dettmaru/Release/Hardware/BaseCircuit_V3/Migrate report.txt

Info: Backing up file "/media/daniel/Data/Sciebo/RhizoTech/Hardware/BaseCircuit_V2/sym-lib-table" to file "/media/daniel/Data/Sciebo/RhizoTech/Hardware/BaseCircuit_V2/rescue-backup/sym-lib-table-2018-10-24-13-03-47".
Info: Backing up file "/media/daniel/Data/Sciebo/RhizoTech/Hardware/BaseCircuit_V2/BaseCircuit_V2.sch" to file "/media/daniel/Data/Sciebo/RhizoTech/Hardware/BaseCircuit_V2/rescue-backup/BaseCircuit_V2-2018-10-24-13-03-47.sch".
Info: Backing up file "/media/daniel/Data/Sciebo/RhizoTech/Hardware/BaseCircuit_V2/Powersupply.sch" to file "/media/daniel/Data/Sciebo/RhizoTech/Hardware/BaseCircuit_V2/rescue-backup/Powersupply-2018-10-24-13-03-47.sch".
Info: Backing up file "/media/daniel/Data/Sciebo/RhizoTech/Hardware/BaseCircuit_V2/Interfaces.sch" to file "/media/daniel/Data/Sciebo/RhizoTech/Hardware/BaseCircuit_V2/rescue-backup/Interfaces-2018-10-24-13-03-47.sch".
Info: Backing up file "/media/daniel/Data/Sciebo/RhizoTech/Hardware/BaseCircuit_V2/UserInterface.sch" to file "/media/daniel/Data/Sciebo/RhizoTech/Hardware/BaseCircuit_V2/rescue-backup/UserInterface-2018-10-24-13-03-47.sch".
Info: Backing up file "/media/daniel/Data/Sciebo/RhizoTech/Hardware/BaseCircuit_V2/BaseCircuit_V2.pro" to file "/media/daniel/Data/Sciebo/RhizoTech/Hardware/BaseCircuit_V2/rescue-backup/BaseCircuit_V2-2018-10-24-13-03-47.pro".
Info: Backing up file "/media/daniel/Data/Sciebo/RhizoTech/Hardware/BaseCircuit_V2/BaseCircuit_V2-cache.lib" to file "/media/daniel/Data/Sciebo/RhizoTech/Hardware/BaseCircuit_V2/rescue-backup/BaseCircuit_V2-cache-2018-10-24-13-03-47.lib".
Info: Backing up file "/media/daniel/Data/Sciebo/RhizoTech/Hardware/BaseCircuit_V2/BaseCircuit_V2-rescue.lib" to file "/media/daniel/Data/Sciebo/RhizoTech/Hardware/BaseCircuit_V2/rescue-backup/BaseCircuit_V2-rescue-2018-10-24-13-03-47.lib".
Info: Backing up file "/media/daniel/Data/Sciebo/RhizoTech/Hardware/BaseCircuit_V2/BaseCircuit_V2-rescue.dcm" to file "/media/daniel/Data/Sciebo/RhizoTech/Hardware/BaseCircuit_V2/rescue-backup/BaseCircuit_V2-rescue-2018-10-24-13-03-47.dcm".
Info: Adding library "BaseCircuit_V2-rescue", file "${KIPRJMOD}/BaseCircuit_V2-rescue.lib" to project symbol library table.
Info: Adding library "BaseCircuit_V1-rescue", file "/media/daniel/Data/Sciebo/RhizoTech/Hardware/BaseCircuit_V1/BaseCircuit_V1-rescue.lib" to project symbol library table.
Info: Adding library "ESP32-footprints-Shem-Lib", file "${KIPRJMOD}/ESP32-footprints-Shem-Lib.lib" to project symbol library table.
Info: Adding library "503398-1892", file "${KIPRJMOD}/503398-1892.lib" to project symbol library table.
Info: Adding library "AddedComponents", file "${KIPRJMOD}/AddedComponents.lib" to project symbol library table.
Info: Adding library "LTC3440", file "${KIPRJMOD}/LTC3440.lib" to project symbol library table.
Symbol "ESP32-WROOM" mapped to symbol library "ESP32-footprints-Shem-Lib".
Symbol "GND" mapped to symbol library "power".
Symbol "GND" mapped to symbol library "power".
Symbol "GND" mapped to symbol library "power".
Symbol "STM32L496Zx" mapped to symbol library "AddedComponents".
Symbol "GND" mapped to symbol library "power".
Symbol "GND" mapped to symbol library "power".
Symbol "Crystal" mapped to symbol library "BaseCircuit_V2-rescue".
Symbol "C" mapped to symbol library "BaseCircuit_V2-rescue".
Symbol "C" mapped to symbol library "BaseCircuit_V2-rescue".
Symbol "GND" mapped to symbol library "power".
Symbol "GND" mapped to symbol library "power".
Symbol "CONN_01X08" mapped to symbol library "BaseCircuit_V2-rescue".
Symbol "CONN_01X10" mapped to symbol library "BaseCircuit_V2-rescue".
Symbol "GND" mapped to symbol library "power".
Symbol "CONN_02X40" mapped to symbol library "BaseCircuit_V2-rescue".
Symbol "CONN_02X40" mapped to symbol library "BaseCircuit_V2-rescue".
Symbol "+3.3V" mapped to symbol library "power".
Symbol "GND" mapped to symbol library "power".
Symbol "GND" mapped to symbol library "power".
Symbol "+5VL" mapped to symbol library "power".
Symbol "GND" mapped to symbol library "power".
Symbol "GND" mapped to symbol library "power".
Symbol "GND" mapped to symbol library "power".
Symbol "GND" mapped to symbol library "power".
Symbol "GND" mapped to symbol library "power".
Symbol "GND" mapped to symbol library "power".
Symbol "GND" mapped to symbol library "power".
Symbol "GND" mapped to symbol library "power".
Symbol "GND" mapped to symbol library "power".
Symbol "GND" mapped to symbol library "power".
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
Symbol "LED" mapped to symbol library "BaseCircuit_V2-rescue".
Symbol "R" mapped to symbol library "BaseCircuit_V2-rescue".
Symbol "LED" mapped to symbol library "BaseCircuit_V2-rescue".
Symbol "R" mapped to symbol library "BaseCircuit_V2-rescue".
Info: Symbol library table mapping complete!
