dettmaru/Release/Hardware/Receiver_BLE/Bill of Material/BOM.ods

Reference | Quantity | Value | Footprint | Händler | Ordercode | Kosten pro Stück | Kosten pro Stück netto | Kosten gesamt | Kommentar
C14 C18 | 2 | 100nF | Capacitor_SMD:C_0603_1608Metric_Pad1.08x0.95mm_HandSolder | Farnell | 1759017 | 0,0838 | 0,0838 | 0,1676
C15 C16 | 2 | 4.7µF | Capacitor_SMD:C_0603_1608Metric_Pad1.08x0.95mm_HandSolder | Farnell | 1833803 | 0,354 | 0,354 | 0,708
C2 | 1 | 1.5pF | Capacitor_SMD:C_0603_1608Metric_Pad1.08x0.95mm_HandSolder
D1 | 1 | LED | LED_SMD:LED_0603_1608Metric – Rot
D2 | 1 | LED | LED_SMD:LED_0603_1608Metric – Grün
D3 | 1 | LED | LED_SMD:LED_0603_1608Metric – Blau
D4 | 1 | LED | LED_SMD:LED_0603_1608Metric – Orange
D101 | 1 | 1,7V | Diode_SMD:D_0603_1608Metric
J1 | 1 | SMA Connector | Connector_Coaxial:SMA_Amphenol_132134-16_Vertical | Reichelt | SMA REV BUE-180 | 1,55 | 1,2555 | 1,2555
P1 P2 P3 P 4P5 P6 P7 P8 P9 | 5 | CONN_01X01 | 2,54mm Stiftleiste 40 Pin | Farnell | 1022264 | 0,83 | 0,83 | 4,15
R101 | 1 | 120R | Resistor_SMD:R_0603_1608Metric |  | 1652832
R1 R13 | 2 | 0R | Resistor_SMD:R_0603_1608Metric | Farnell | 9233130RL | 0,0177 | 0,0177 | 0,0354
R2 R3 R5 R6 | 4 | 220 | Resistor_SMD:R_0603_1608Metric | Farnell | 2446615 | 0,0011 | 0,0011 | 0,0044
R4 R7 R8 R9 R10 R11 | 6 | 10k | Resistor_SMD:R_0603_1608Metric | Farnell | 2447230 | 0,0061 | 0,0061 | 0,0366
SW1 | 1 | SW_DIP_x05 | Button_Switch_SMD:SW_DIP_SPSTx05_Slide_6.7x14.26mm_W6.73mm_P2.54mm_LowProfile_JPin | Farnell | 2989860 | 0,952 | 0,952 | 0,906304
SW2 | 1 | SW_Push | Button_Switch_SMD:SW_SPST_EVQQ2 | Farnell | 2830675 | 0,725 | 0,725 | 0,725
U101 | 1 | nRF52840 | Rhizo_Receiver_Shield_final_Module:Waveshare_nRF528840 | Eckstein | WS15897 | 14,99 | 12,1419 | 12,1419
