dettmaru/Release/Hardware/Receiver_BLE/Datasheets/nRF52840-QIAA Reference Layout 1_1/Bill of Materials/nrf52840_qiaa_var1_bom.xls

Bill of material
Board: | nRF52840-QIAA Ref. Layout (LDO only, VBUS supply)
Version: | 1.1
Designator | Value | Description | Footprint Doc
C1, C2, C17, C18 | 12pF | Capacitor, NP0, ±2% | 0402
C3 | 0.8pF | Capacitor, NP0, ±10% | 0402
C4 | 0.5pF | Capacitor, NP0, ±10% | 0402
C5, C7, C8, C12 | 100nF | Capacitor, X7R, ±10% | 0402
C6, C20 | 4.7µF | Capacitor, X7R, ±10% | 0603
C9 | 820pF | Capacitor, NP0, ±5% | 0402
C10, C13, C22 | N.C. | Not mounted | 0402
C11 | 100pF | Capacitor, NP0, ±5% | 0402
C14, C15 | 1.0µF | Capacitor, X7R, ±10% | 0603
C19 | 4.7µF | Capacitor, X7S, ±10% | 0603
L1 | 4.7nH | High frequency chip inductor ±5% | 0402
R1 | 4R7 | Resistor, ±1%, 0.063W | 0402
U1 | nRF52840-QIAA | Multi-protocol Bluetooth Low Energy, IEEE 802.15.4, ANT and 2.4GHz proprietary system-on-chip | AQFN-73
X1 | 32MHz | XTAL SMD 2016, 32MHz, Cl=8pF, Total Tol: ±40ppm | XTAL_2016
X2 | 32.768kHz | XTAL SMD 3215, 32.768kHz, Cl=9pF, Total Tol: ±50ppm | XTAL_3215
