dettmaru/Release/Hardware/Receiver_BLE/Datasheets/nRF52840 Development Kit - Hardware files 1_0_0/PCA10056-nRF52840 Development Board 1_0_0/Production files/BOM/PCA10056_BOM_Web.xls

Bill of material
Board: | PCA10056
Version: | 1.0.0
Designator | Value | Description | Assembly | Footprint Doc | Manufacturer | Manufacturer Part Number
Bat1 | Bat Holder CR2032 | Bat Holder CR2032 SMD |  | CR2032_HOLDER_SMD | Comfortable | BC-2001
C1, C2, C17, C18 | 12pF | Capacitor, NP0, ±2% |  | 0402
C3, C4 | 1.0pF | Capacitor, NP0, ±0.1pF |  | 0402
C5, C7, C8, C12, C24, C25, C26, C28, C31, C32, C33, C34, C35, C36, C37, C40, C41, C42, C43, C45, C48, C49, C50, C62, C65, C68, C69, C85, C89, C90, C93 | 100nF | Capacitor, X7R, ±10% |  | 0402
C6, C20 | 4.7µF | Capacitor, X7R, ±10% |  | 0603 | Samsung | CL10B475KQ8NQNC
C9 | 820pF | Capacitor, NP0, ±5% |  | 0402
C10, C13, C22, C51, C52 | N.C. | Not mounted | Not mounted | 0402
C11 | 100pF | Capacitor, NP0, ±5% |  | 0402
C14, C15, C91, C92 | 1.0µF | Capacitor, X7R, ±10% |  | 0603
C16 | 47nF | Capacitor, X7R, ±10% |  | 0402
C19, C21 | 4.7µF | Capacitor, X7S, ±10% |  | 0603
C23 | 1.2pF | Capacitor, NP0, ±0.1pF |  | 0402
C27 | 10pF | Capacitor, NP0, ±2% |  | 0402
C29, C30 | 18pF | Capacitor, NP0, ±5% |  | 0402
C38, C39, C61, C64 | 10µF | Capacitor, X5R, ±20% |  | 0603
C44, C60, C63 | 10nF | Capacitor, X7R, ±10% |  | 0402
C46, C47 | 300pF | Capacitor, NP0, ±5% |  | 0402
C66, C67 | 100nF | Capacitor, X7R, ±10% | Not mounted | 0402
C80, C82, C83, C88 | 10µF | Capacitor, 0603, 25V, X5R |  | 0603
C81 | 15pF | Capacitor, NP0, ±5% |  | 0402
C84 | 470nF | Capacitor, X5R, ±10% |  | 0402
C86 | 4.7µF | Capacitor, X5R, ±10% |  | 0805
C87 | 150pF | Capacitor, NP0, ±5% |  | 0402
D60, D61 | PRTR5V0U2X | Ultra low capacitance double rail-to-rail ESD protection diode |  | SOT-143B | NXP | PRTR5V0U2X
D80, D81, D82, D83 | NSR0620P2T5G | 20V schottky barrier diode, Vf 350 mV @ 100 mA, Ir 2.0 µA @ 10 V, If 500 mA |  | SOD-923 | ON Semiconductor | NSR0620P2T5G
D84 | MBRM110E | Diode Schottky Vf=0.455V @ 100mA, Vr=10V, If=1000mA, Ir=1µA @ 10V |  | DO-216AA | ON Semiconductor | MBRM110ET1G
FB60, FB61, FB62, FB63, FB64, FB65 | 120R/0.55A | Ferrite Bead, 120 Ohm @ 100MHz, 500mA, 250 mOhm Max |  | 0402 | Murata | BLM15AG121SN1D
J1 | MM8130-2600 | Coaxial Connector with Switch |  | COAXIAL-SWF | Murata | MM8130-2600
J2, J3 | MicroUSB-B | MicroUSB-B-SMT |  | USB-Micro-B-RA-SMD-PiP | Allen Creations Corp. | AJU55-BS2111-L
J4 | TC2050-IDC | CBL PLUG-OF-NAILS 10-PIN | Not mounted | TC2050-IDC-NLFP | Tag-Connect LLC | TC2050-IDC-NLFP
J5 | FPC 0.5mm RA SMD | 0.5mm FPC, 5P,Right Angle SMT,Double Contact,H=1.2mm,White, Tin plated |  | FPC_05P-0.5mm-RA-SMD | W-CON | 5141-05RZDNWR01
J6 | HDR-2, 1mm | 1.0mm pitch connector side entry SMD |  | SM02B-SRSS-TB | JST | SM02B-SRSS-TB(LF)(SN)
L1 | 3.9nH | Inductor, 170mA, ±0.1nH |  | 0402 | Murata | LQP15MN3N9B02D
L2, L4 | 10µH | Inductor, 80mA, ±10% |  | 0603 | Taiyo Yuden | LBMF1608T100K
L3 | 15nH | Inductor, 320mA, ±5% |  | 0402 | Taiyo Yuden | HK100515NJ-T
L80 | 2.2µH | Ferrite Inductor, Shielded, 1,5A, 72mOhm |  | 1212 | Taiyo Yuden | NR3015T2R2M
L81 | 4.7µH | Ferrite Inductor, Shielded, 1,04A, 144mOhm |  | 1212 | Taiyo Yuden | NR3015T4R7M
LED1, LED2, LED3, LED4 | L0603G | LED, Green, 0603, 573nm, Vf=2.0V, 24mcd, - 40 to +85°C |  | 0603 | Victory Electronics | VS 25C7M5
LED5 | LED RG | Ultra bright AlInGaP Bi-Color LED |  | LED_DUAL_0606 | Lite-On Inc | LTST-C195KGJRKT
P1, P3, P6 | Socket 1x8 | Socket 1x8, 2.54mm (100mil), SMD |  | SOCKET_1x8_SMD | W-CON | 2171-108MS0CUNR1
P2 | Socket 1x6 | Socket 1x6, 2.54mm (100mil), SMD |  | SOCKET_1x6_SMD | W-CON | 2171-106MS0CUNR1
P4 | Socket 1x10 | Socket 1x10, 2.54mm (100mil), SMD |  | SOCKET_1x10_SMD | W-CON | 2171-110MS0CUNR1
P5 | Pin Hdr 2x3 | Pin Header 2x3, 2.54mm (100mil) SMD |  | HDR_2x3-SMD | W-CON | 1125-1203S0M116R1
P7, P9, P12 | Pin List 1x8 | Pin List 1x8, 2.54mm (100mil), SMD | Not mounted | LIST_1x8_SMD | W-CON | 1125-1108S0M116R2
P8 | Pin List 1x6 | Pin List 1x6, 2.54mm (100mil), SMD | Not mounted | LIST_1x6_SMD | W-CON | 1125-1106S0M116R2
P10 | Pin List 1x10 | Pin List 1x10, 2.54mm (100mil), SMD | Not mounted | LIST_1x10_SMD | W-CON | 1125-1110S0M116R2
P11 | Socket 2x3 | Socket 2x3, 2.54mm (100mil), SMD | Not mounted | SOCKET_2x3_SMD-2.54mm-bottom | W-CON | 2171-203MS0CUNR1
P13, P15, P17 | Pin Header 2x8 | Pin Header 2x8, 2.54mm (100mil) | Not mounted | HDR_2x8
P14 | Pin Header 2x6 | Pin Header 2x6, 2.54mm (100mil) | Not mounted | HDR_2x6
P16 | Pin Header 2x10 | Pin Header 2x10, 2.54mm (100mil) | Not mounted | HDR_2x10
P18, P19 | Pin Header 2x5, 1.27mm | Pin Header 2x5, 1.27mm (50mil), SMD, Keying Shroud |  | HDR_2x5-SMD-1.27mm | W-CON | 3132-10MS0BK00R1
P20 | Pin List 1x12 | Pin List 1x12, 2.54mm (100mil), SMD |  | LIST_1x12_SMD
P21, P22, P23 | Pin List 1x2, Angled | Pin List 1x2, 2.54mm (100mil), Right Angled, SMD |  | LIST_ANG_1x2-SMD-2.54MM | W-CON | 1125B-1102S0Z135R2
P24 | Socket 2x9 | Socket 2x9, 2.54mm (100mil), SMD |  | SOCKET_2x9_SMD-2.54mm | Samtec | SSM-109-F-DV
P25 | Pin Header 2x10, 1.27mm | Pin Header 2x10, 1.27mm (50mil), SMD, Keying Shroud | Not mounted | HDR_2x10-SMD-1.27mm | Samtec | FTSH-110-01-F-DV-K
P26 | Socket 1x12 | Socket 1x12, 2.54mm (100mil), SMD | Not mounted | SOCKET_1x12_SMD | Samtec | SSM-109-L-SV
P27 | Pin List 1x2 | Pin List 1x2, 2.54mm (100mil) | Not mounted | LIST_1x2
P28 | Pin List 1x3 | Pin List 1x3, 2.54mm (100mil) | Not mounted | LIST_1x3
Q20, Q21, Q40 | FDG6321C | Fairchild, FDG6321C, Dual N & P Channel Digital FET |  | SC70-6 | Fairchild | FDG6321C
Q80 | FCX690BTA | 45V NPN high gain power transistor |  | SOT-89 | Diodes Incorporated | FCX690BTA
Q81 | FDG6303N | Fairchild, FDG6303N, Dual N-Channel Digital FET |  | SC70-6 | Fairchild | FDG6303N
Q82, Q83 | RV2C010UNT2L | N-Channel MOSFET, 20V, 1A, 470mOhm, 400mW |  | DFN-3 | Rohm Semiconductor | RV2C010UNT2L
R1, R2, R30, R44, R46, R69, R70 | 0R | Resistor, ±5%, 0.063W |  | 0402
R3, R4, R22, R23, R24, R27, R49 | 10k | Resistor, ±1%, 0.063W |  | 0402
R20, R21, R47, R48, R50, R51 | 220R | Resistor, ±1%, 0.063W |  | 0402
R25 | 6k8 | Resistor, ±1%, 0.063W |  | 0402
R26 | 47k | Resistor, ±1%, 0.063W |  | 0402
R28, R29 | 150R | Resistor, ±1%, 0.063W |  | 0402
R40 | 150k | Resistor, ±1%, 0.063W |  | 0402
R41, R68, R86, R87, R89 | 1M0 | Resistor, ±1%, 0.063W |  | 0402
R43, R45, R54, R88, R90, R91 | N.C. | Not mounted | Not mounted | 0402
R52, R53, R64, R65, R66, R67 | 4k7 | Resistor, ±1%, 0.063W |  | 0402
R60, R61 | 39R | Resistor, ±1%, 0.063W |  | 0402
R62, R63 | 10k | Resistor, ±1%, 0.063W | Not mounted | 0402
R80 | 270k | Resistor, ±1%, 0.063W |  | 0402
R81 | 30k | Resistor, ±1%, 0.063W |  | 0402
R82 | 330k | Resistor, ±1%, 0.063W |  | 0402
R83 | 820k | Resistor, ±1%, 0.063W |  | 0402
R84 | 120k | Resistor, ±1%, 0.063W |  | 0402
R85 | 470k | Resistor, ±1%, 0.063W |  | 0402
R92, R94 | 10M | Resistor, ±1%, 0.063W |  | 0402
R93 | 1k | Resistor, ±1%, 0.063W |  | 0402
SW1, SW2, SW3, SW4, SW5 | PB SW | Tactile Switch, SPNO, SMD, 160gf, 6.2x6.3x2.5mm |  | Switch-PB-6.2x6.3mm-SMD | Dailywell | TS604VM1-025BR-R
SW6, SW8 | MKH-22D14-G2-B | Slide Switch DPDT |  | MKH-22D14-G2-B | Dailywell | MKH-22D14-G2-B
SW7 | Switch | SMD slide Switch (ON-ON) |  | CJS-120xA | Copal Electronics Inc | CJS-1200TA
SW9 | JS203011JCQN | Slide Switch DP3T 300mA 6V |  | Switch-Slide-J-Lead-DP3T-13x3.5mm | C&K Components | JS203011JCQN
SW10 | CAS-220TA | Slide Switch DPDT J Hook |  | CAS-220TA | Copal Electronics Inc | CAS-220TA
U1 | nRF52840-QIAA | Multi-protocol Bluetooth Low Energy, IEEE 802.15.4, ANT and 2.4GHz proprietary system-on-chip |  | AQFN-73 | Nordic Semiconductor | nRF52840-QIAAC0
U2 | ATSAM3U2CA-AU | IC MCU 32bit 128kB flash 100LQFP |  | LQFP-100 | Atmel | ATSAM3U2CA-AU
U3 | MX25R6435F | Ultra low power, 64M-bit, serial multi I/O flash memory |  | WSON-8 | Macronix | MX25R6435FZNIL0
U4, U13, U14, U15, U16, U17, U18, U24 | SC728CSTRT | Semtech, 2A Low Vin, Very Low Ron, Load Switch, 4DSBGA |  | WCSP-4 | Semtech Corporation | SC728CSTRT
U5, U6, U7, U8 | FSA2466UMX | Data / Audio Low-Voltage Dual DPDT Analog Switch |  | UFQFN-16 | Fairchild Semiconductor | FSA2466UMX
U11 | XC9236 | 600mA Driver Transistor Built-In, Synchronous Step-Down DC/DC Converters |  | USP-6C | Torex Semiconductor | XC9236D08CER-G
U12 | XC9131 | 1A Driver Transistor Built-In, Multi Functional Step-Up DC/DC Converter |  | UFDFN-10 | Torex Semiconductor | XC9131H05CDR-G
U19 | TS27L2IPT | Precision very low power CMOS dual operational amplifier |  | TSSOP-8 | STMicroelectronics | TS27L2IPT
U20, U25 | 74LVC1G08 | Single 2-Input AND Gate |  | SC70-5 | NXP Semiconductors | 74LVC1G08GW
U21 | 74LVC1G11 | Single 3-input AND gate |  | SC70-6 | NXP Semiconductors | 74LVC1G11GW
U22, U23 | TCK106AF | 1.0 A Load Switch IC with Slew Rate Control Driver in Small Package |  | SOT-25 | Toshiba | TCK106AF,LF
X1 | 32MHz | XTAL SMD 2016, 32MHz, Cl=8pF, Tol: ±10ppm, Stab: ±15ppm |  | XTAL_2016 | Golledge | MP06003
X2 | 32.768kHz | XTAL SMD 2012, 32.768kHz, 9pF, ±20ppm |  | XTAL_3215 | NDK | NX3215SA-32.768K-STD-MUA-9
X20 | 12MHz | XTAL SMD 3225, 12MHz, Cl=18pF, Tol: ±30ppm, Stab: ±30ppm |  | XTAL_3225 | TXC Corporation | 7M-12.000MAAJ-T
