dettmaru/Release/Hardware/Receiver_BLE/Datasheets/nRF52840 USB Dongle - Hardware files 1_0_0/PCA10059-nRF52840 USB Dongle 1_0_0/Production files/BOM/PCA10059_BOM_Web.xls

Bill of material
Board: | PCA10059
Version: | 1.0.0
Designator | Value | Description | Assembly | Footprint Doc | Manufacturer | Manufacturer Part Number
C1, C2, C17, C18 | 12pF | Capacitor, NP0, ±2% |  | 0201
C3, C4 | 1.0pF | Capacitor, NP0, ±5% |  | 0201
C5, C7, C8, C12, C22, C24, C27 | 100nF | Capacitor, X5R, ±10% |  | 0201
C6, C20 | 4.7µF | Capacitor, X5R, ±10% |  | 0603
C9 | 820pF | Capacitor, X7R, ±10% |  | 0201
C10, C13, C25 | N.C. | Not mounted | Not mounted | 0201
C11 | 100pF | Capacitor, NP0, ±2% |  | 0201
C14, C15 | 1.0µF | Capacitor, X7R, ±10% |  | 0603
C16 | 47nF | Capacitor, X5R, ±10% |  | 0201
C19, C23 | 4.7µF | Capacitor, X5R, ±20% |  | 0402
C21 | 10nF | Capacitor, X7R, ±10% |  | 0201
C26 | 1.5pF | Capacitor, NP0, ±0.1pF |  | 0201
C28, C29 | N.C. | Not mounted | Not mounted | 0402
D1 | PRTR5V0U2X | Ultra low capacitance double rail-to-rail ESD protection diode |  | SOT-143B | NXP | PRTR5V0U2X
FB1, FB2 | 120R/0.85A | Ferrite Bead, 120 Ohm @ 100MHz, 850mA, 150 mOhm Max |  | 0402 | Taiyo Yuden | BKP0603HS121-T
L1 | 3.9nH | Inductor, 400mA, ±0.1nH |  | 0201
L2, L4 | 10µH | Inductor, 80mA, ±10% |  | 0603 | Taiyo Yuden | LBMF1608T100K
L3 | 15nH | Inductor, 320mA, ±5% |  | 0402 | Taiyo Yuden | HK100515NJ-T
LD1 | L0603G | LED, Green, 0603, 573nm, Vf=2.0V, 24mcd, - 40 to +85°C |  | 0603 | Victory Electronics | VS 25C7M5
LD2 | LED RGB | RGB LED 1.60 mm x 0.80 mm SMD |  | LED_RGB_0603 | Kingbright Company LLC | APHF1608LSEEQBDZGKC
P1 | Pin Header 2x5, 1.27mm | Pin Header 2x5, 1.27mm (50mil), SMD, Keying Shroud | Not mounted | HDR_2x5-SMD-1.27mm | W-CON | 3132-10MS0BK00R1
R1 | 0R | Resistor, ±5%, 0.05W |  | 0201
R2 | 10k | Resistor, ±1%, 0.05W |  | 0201
R3 | 220R | Resistor, ±1%, 0.05W |  | 0201
R4 | 1k2 | Resistor, ±1%, 0.05W |  | 0201
R5 | 2k2 | Resistor, ±1%, 0.05W |  | 0201
R6 | 390R | Resistor, ±1%, 0.05W |  | 0201
SW1 | PB SW | Tactile Switch, SPNO, SMD, 260gf, 4.2x3.2x2.5mm |  | PTS810 | C&K Components | PTS810 SJK 250 SMTR LFS
SW2 | PTS840 GK SMTR LFS | Microminiature SMT Switch, Side Actuated |  | PTS840 Gx | C&K Components | PTS840 GK SMTR LFS
U1 | nRF52840-QIAA | Multi-protocol Bluetooth Low Energy, IEEE 802.15.4, ANT and 2.4GHz proprietary system-on-chip |  | AQFN-73 | Nordic Semiconductor | nRF52840-QIAAC0
X1 | 32MHz | XTAL SMD 2016, 32MHz, Cl=8pF, Tol: ±10ppm, Stab: ±10ppm |  | XTAL_2016 | Murata | XRCGB32M000F1H01R0
X2 | 32.768kHz | XTAL SMD 2012, 32.768kHz, 9pF, ±20ppm |  | XTAL_2012 | Seiko | SC20S-9.0PF20PPM
