dettmaru/Release/Hardware/Receiver_BLE/Bill of Material/price_calculation_receiver_shield.ods

Kostenaufstellung Empfängermodul Hardware
Bauteilbezeichnung | Wert | Anzahl pro Platine | Händler | Ordercode | Kosten pro Stück | Kosten pro Stück netto | Kosten gesamt | Kommentar
nRF52840 Module |  | 1 | Eckstein | WS15897 | 14,99 | 12,1419 | 12,1419
Kondensator | 100nF | 7 | Farnell | 1759017 | 0,0838 | 0,0838 | 0,5866
Kondensator | 1µF | 2 | Farnell | 1759398 | 0,116 | 0,116 | 0,232
Kondensator | 4,7µF | 2 | Farnell | 1833803 | 0,354 | 0,354 | 0,708
Kondensator | 1,5pF | 1 | Farnell | 1759042 | 0,0339 | 0,0339 | 0,0339
Widerstand | 10k | 6 | Farnell | 2447230 | 0,0061 | 0,0061 | 0,0366
Widerstand | 0R | 3 | Farnell | 9233130RL | 0,0177 | 0,0177 | 0,0531
Widerstand | 220R | 4 | Farnell | 2446615 | 0,0011 | 0,0011 | 0,0044
Taster |  | 1 | Farnell | 2830675 | 0,725 | 0,725 | 0,725
SMD LED |  | 4 | Farnell | 2369164 | 0,114 | 0,114 | 0,456
SMA REV Stecker |  | 1 | Reichelt | SMA REV BUE-180 | 1,55 | 1,2555 | 1,2555
Socket_Strip_1x08 |  | 2 | Farnell | 1022264 | 0,83 | 0,83 | 1,66
SW_DIP_x05 |  | 1 | Farnell | 2989860 | 0,952 | 0,952 | 0,952
Platine |  | 1 | Aisler |  | 8,06 | 6,5286 | 6,5286
 |  |  |  |  | Summe | 25,3736
