dettmaru/Release/Hardware/BaseCircuit_V3/3Dmodels/Button.stp

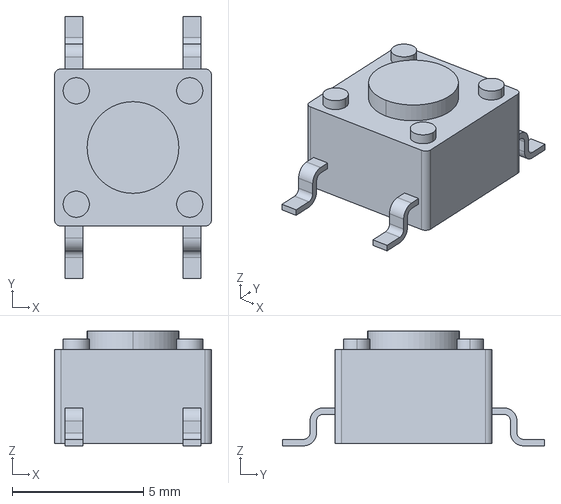
[picture p27: CAD file, 2022-01-10]
Hardware/BaseCircuit_V3/3Dmodels/Button.stp
6.00 x 10.0 x 4.38 mm
