dettmaru/Release/Hardware/BaseCircuit_V3/3Dmodels/tantalum 10uF.stp

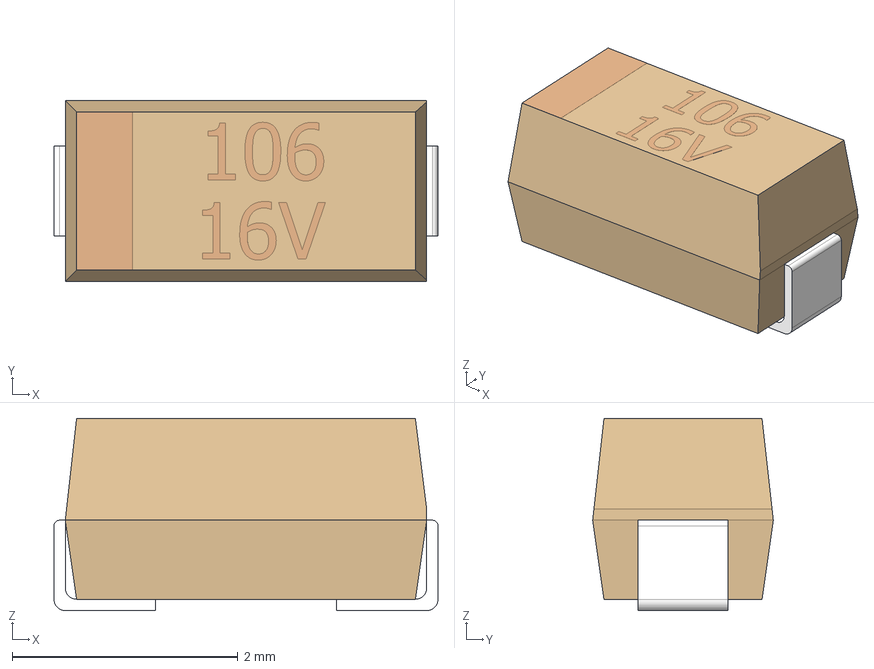
[picture p28: CAD file, 2022-01-10]
Hardware/BaseCircuit_V3/3Dmodels/tantalum 10uF.stp
3.40 x 1.60 x 1.70 mm
