dettmaru/Release/Hardware/BaseCircuit_V3/3Dmodels/QUECTEL_M95.STEP

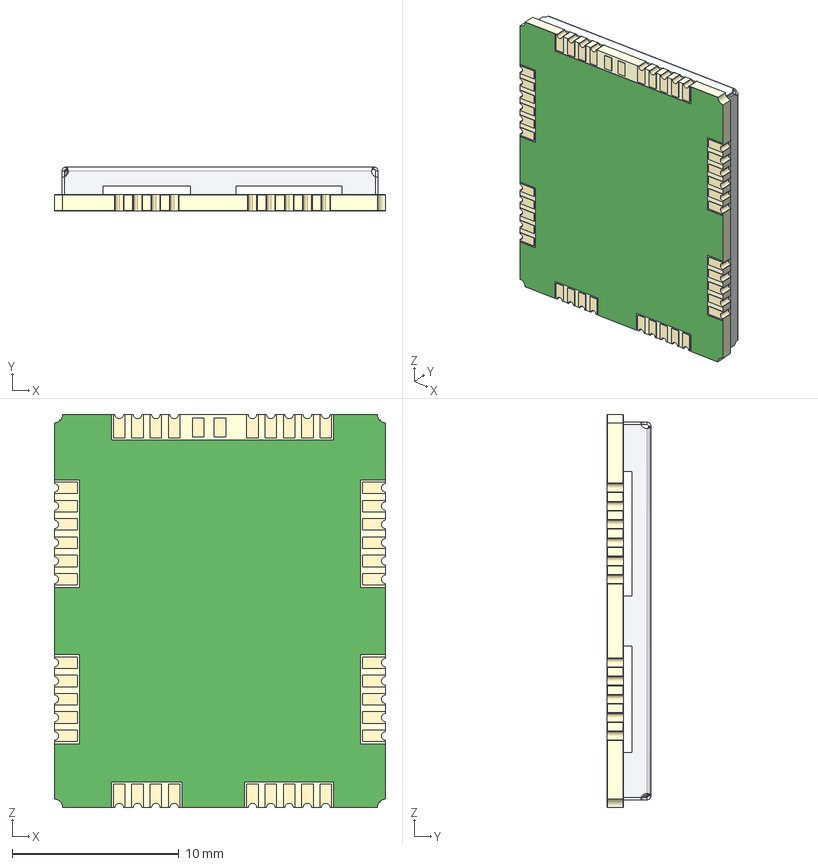
[picture p29: CAD file, 2022-01-10]
Hardware/BaseCircuit_V3/3Dmodels/QUECTEL_M95.STEP
19.9 x 2.67 x 23.6 mm
