dettmaru/Release/Hardware/BaseCircuit_V3/3Dmodels/quectel BC95.STEP

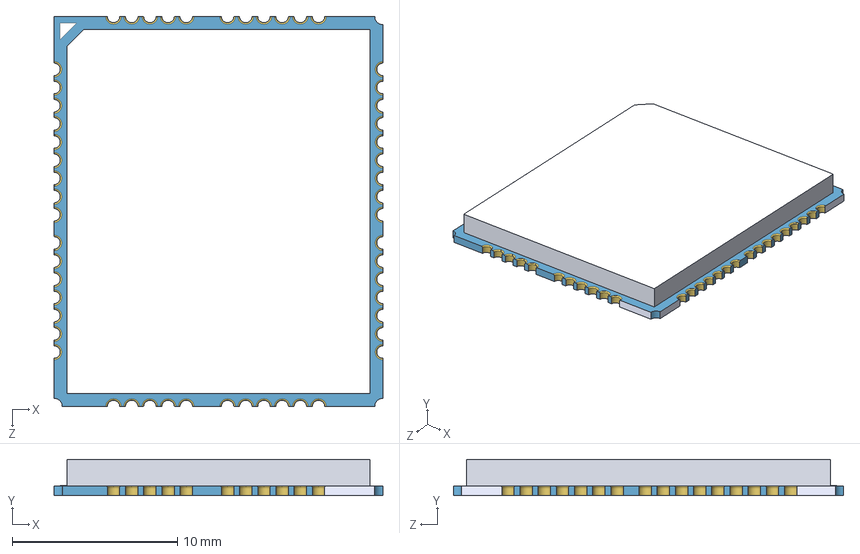
[picture p30: CAD file, 2022-01-10]
Hardware/BaseCircuit_V3/3Dmodels/quectel BC95.STEP
19.9 x 2.20 x 23.6 mm
