dettmaru/Release/Hardware/BaseCircuit_V3/3Dmodels/SR4L002_Lucida.STEP

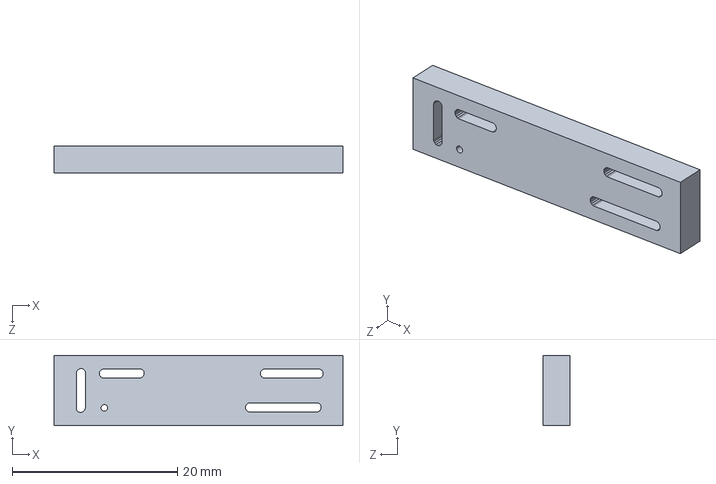
[picture p31: CAD file, 2022-01-10]
Hardware/BaseCircuit_V3/3Dmodels/SR4L002_Lucida.STEP
35.0 x 8.50 x 3.29 mm
