dettmaru/Release/Hardware/BaseCircuit_V3/3Dmodels/SIMHolder.stp

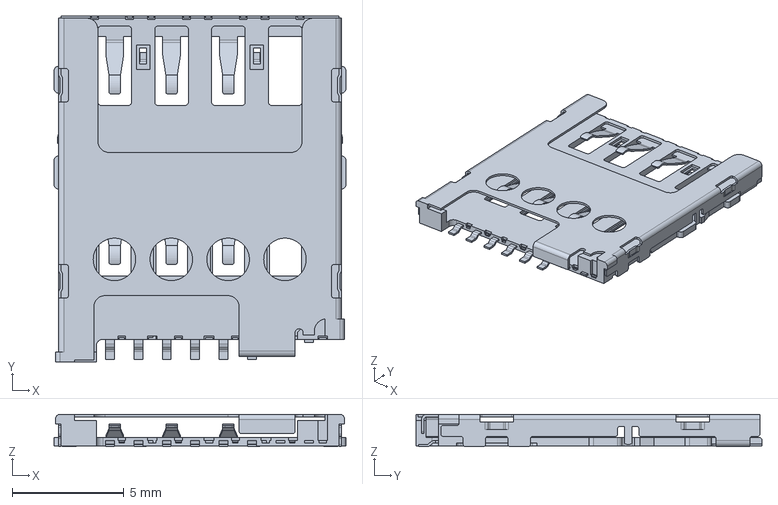
[picture p32: CAD file, 2022-01-10]
Hardware/BaseCircuit_V3/3Dmodels/SIMHolder.stp
13.0 x 15.5 x 1.45 mm
