dettmaru/Release/Hardware/BaseCircuit_V3/3Dmodels/SMA-J-P-H-ST-EM1.stp

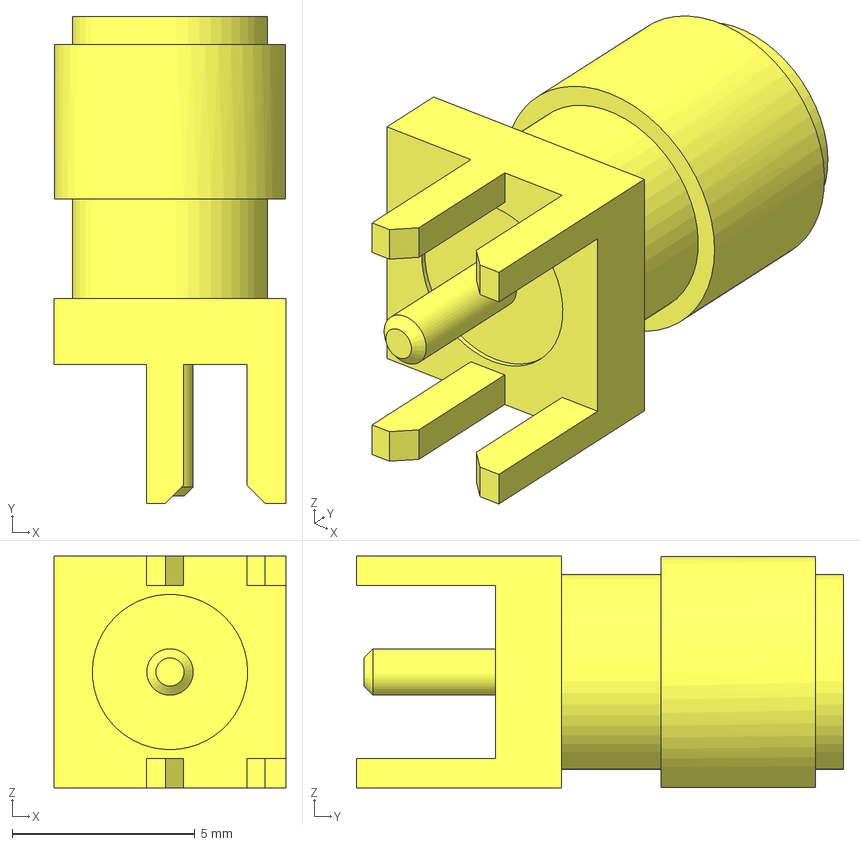
[picture p33: CAD file, 2022-01-10]
Hardware/BaseCircuit_V3/3Dmodels/SMA-J-P-H-ST-EM1.stp
6.35 x 13.3 x 6.35 mm
