dettmaru/Release/Hardware/BaseCircuit_V3/3Dmodels/TVSDiode.STEP

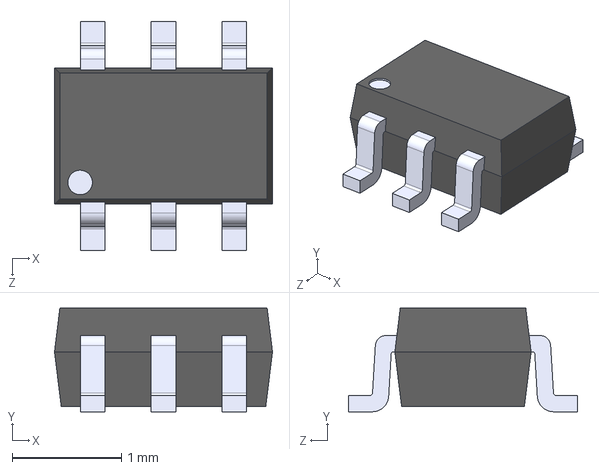
[picture p34: CAD file, 2022-01-10]
Hardware/BaseCircuit_V3/3Dmodels/TVSDiode.STEP
2.00 x 0.95 x 2.10 mm
sc70_pin x 6
SC70_0M65_2MX1M25X0M9_BODY
