dettmaru/Release/Hardware/BaseCircuit_V3/3Dmodels/KiCAD-ESP-WROOM-32.step

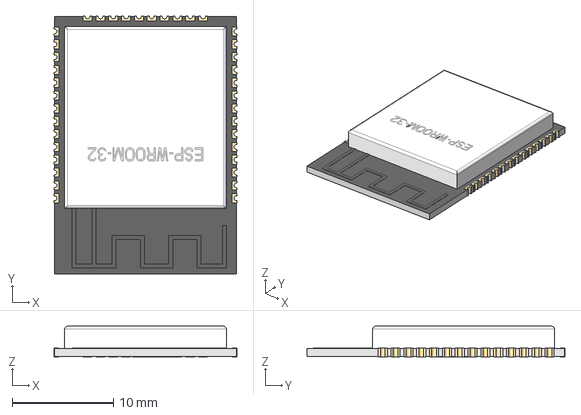
[picture p35: CAD file, 2022-01-10]
Hardware/BaseCircuit_V3/3Dmodels/KiCAD-ESP-WROOM-32.step
18.1 x 25.5 x 3.04 mm
