dettmaru/Release/Hardware/BaseCircuit_V3/3Dmodels/503398-1892_stp/5033981892.stp

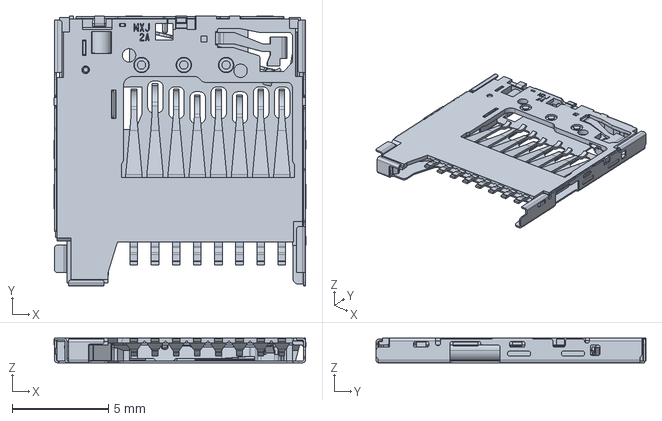
[picture p36: CAD file, 2022-01-10]
Hardware/BaseCircuit_V3/3Dmodels/503398-1892_stp/5033981892.stp
13.1 x 14.0 x 1.28 mm
