dettmaru/Release/Hardware/BaseCircuit_V3/3Dmodels/503398-1892--3DModel-STEP-56544.STEP

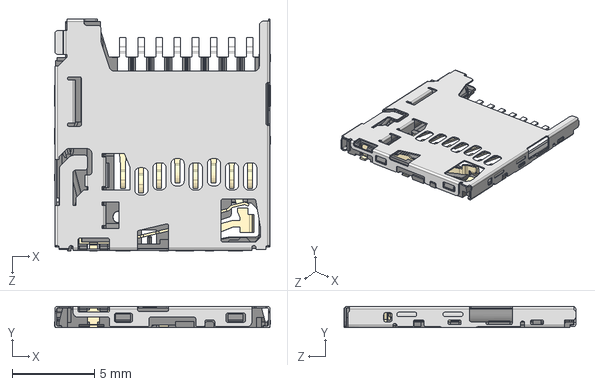
[picture p37: CAD file, 2022-01-10]
Hardware/BaseCircuit_V3/3Dmodels/503398-1892--3DModel-STEP-56544.STEP
13.1 x 1.28 x 14.1 mm
