dettmaru/Release/(list of files, cad)

Other CAD files:
Hardware/BaseCircuit_V3/3Dmodels/503398-1892_igs/5033981892.igs
Hardware/BaseCircuit_V3/3Dmodels/503398-1892_prt/5033981892.prt
