dettmaru/Release/(list of files, drawings)

Other design files:
Hardware/Receiver_BLE/Datasheets/nRF52840 Development Kit - Hardware files 1_0_0/PCA10056-nRF52840 Development Board 1_0_0/Altium Designer files/pca10056.PrjPCB
Hardware/Receiver_BLE/Datasheets/nRF52840 Development Kit - Hardware files 1_0_0/PCA10056-nRF52840 Development Board 1_0_0/Altium Designer files/pca10056_sheet1_cover.SchDoc
Hardware/Receiver_BLE/Datasheets/nRF52840 Development Kit - Hardware files 1_0_0/PCA10056-nRF52840 Development Board 1_0_0/Altium Designer files/pca10056_sheet2_nrf52840_mcu.SchDoc
Hardware/Receiver_BLE/Datasheets/nRF52840 Development Kit - Hardware files 1_0_0/PCA10056-nRF52840 Development Board 1_0_0/Altium Designer files/pca10056_sheet3_pin_map.SchDoc
Hardware/Receiver_BLE/Datasheets/nRF52840 Development Kit - Hardware files 1_0_0/PCA10056-nRF52840 Development Board 1_0_0/Altium Designer files/pca10056_sheet4_interface_mcu.SchDoc
Hardware/Receiver_BLE/Datasheets/nRF52840 Development Kit - Hardware files 1_0_0/PCA10056-nRF52840 Development Board 1_0_0/Altium Designer files/pca10056_sheet5_misc.SchDoc
Hardware/Receiver_BLE/Datasheets/nRF52840 Development Kit - Hardware files 1_0_0/PCA10056-nRF52840 Development Board 1_0_0/Altium Designer files/pca10056_sheet6_connectors.SchDoc
Hardware/Receiver_BLE/Datasheets/nRF52840 Development Kit - Hardware files 1_0_0/PCA10056-nRF52840 Development Board 1_0_0/Altium Designer files/pca10056_sheet7_power_supply.SchDoc
Hardware/Receiver_BLE/Datasheets/nRF52840 Development Kit - Hardware files 1_0_0/PCA64110-NFC Antenna Flexprint 1_0_0/Altium Designer files/400148.PcbDoc
Hardware/Receiver_BLE/Datasheets/nRF52840 Development Kit - Hardware files 1_0_0/PCA64110-NFC Antenna Flexprint 1_0_0/Altium Designer files/pca64110.PrjPCB
Hardware/Receiver_BLE/Datasheets/nRF52840 Development Kit - Hardware files 1_0_0/PCA64110-NFC Antenna Flexprint 1_0_0/Altium Designer files/pca64110.SchDoc
Hardware/Receiver_BLE/Datasheets/nRF52840 USB Dongle - Hardware files 1_0_0/PCA10059-nRF52840 USB Dongle 1_0_0/Altium Designer files/400250.PcbDoc
Hardware/Receiver_BLE/Datasheets/nRF52840 USB Dongle - Hardware files 1_0_0/PCA10059-nRF52840 USB Dongle 1_0_0/Altium Designer files/pca10059.PrjPCB
Hardware/Receiver_BLE/Datasheets/nRF52840 USB Dongle - Hardware files 1_0_0/PCA10059-nRF52840 USB Dongle 1_0_0/Altium Designer files/pca10059.SchDoc
Hardware/Receiver_BLE/Datasheets/nRF52840-QIAA Reference Layout 1_1/Altium Designer files/nrf52840_qiaa_var1.PcbDoc
Hardware/Receiver_BLE/Datasheets/nRF52840-QIAA Reference Layout 1_1/Altium Designer files/nrf52840_qiaa_var1.PrjPCB
Hardware/Receiver_BLE/Datasheets/nRF52840-QIAA Reference Layout 1_1/Altium Designer files/nrf52840_qiaa_var1.SchDoc
Hardware/Receiver_BLE/Datasheets/nRF52840-QIAA Reference Layout 1_1/Altium Designer files/nrf52840_qiaa_var2.PcbDoc
Hardware/Receiver_BLE/Datasheets/nRF52840-QIAA Reference Layout 1_1/Altium Designer files/nrf52840_qiaa_var2.PrjPCB
Hardware/Receiver_BLE/Datasheets/nRF52840-QIAA Reference Layout 1_1/Altium Designer files/nrf52840_qiaa_var2.SchDoc
Hardware/Receiver_BLE/Datasheets/nRF52840-QIAA Reference Layout 1_1/Altium Designer files/nrf52840_qiaa_var3.PcbDoc
Hardware/Receiver_BLE/Datasheets/nRF52840-QIAA Reference Layout 1_1/Altium Designer files/nrf52840_qiaa_var3.PrjPCB
Hardware/Receiver_BLE/Datasheets/nRF52840-QIAA Reference Layout 1_1/Altium Designer files/nrf52840_qiaa_var3.SchDoc
Hardware/Receiver_BLE/Datasheets/nRF52840-QIAA Reference Layout 1_1/Altium Designer files/nrf52840_qiaa_var4.PcbDoc
Hardware/Receiver_BLE/Datasheets/nRF52840-QIAA Reference Layout 1_1/Altium Designer files/nrf52840_qiaa_var4.PrjPCB
Hardware/Receiver_BLE/Datasheets/nRF52840-QIAA Reference Layout 1_1/Altium Designer files/nrf52840_qiaa_var4.SchDoc
Hardware/Receiver_BLE/Datasheets/nRF52840-QIAA Reference Layout 1_1/Altium Designer files/nrf52840_qiaa_var5.PcbDoc
Hardware/Receiver_BLE/Datasheets/nRF52840-QIAA Reference Layout 1_1/Altium Designer files/nrf52840_qiaa_var5.PrjPCB
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
