dettmaru/Release/Hardware/Receiver_BLE/PCB/Empfaenger Modul PCB Waveshare V2/Rhizo_Receiver_Shield_V2.kicad_pcb

## KiCad design Hardware/Receiver_BLE/PCB/Empfaenger Modul PCB Waveshare V2/Rhizo_Receiver_Shield_V2.kicad_pcb (2022-01-10)

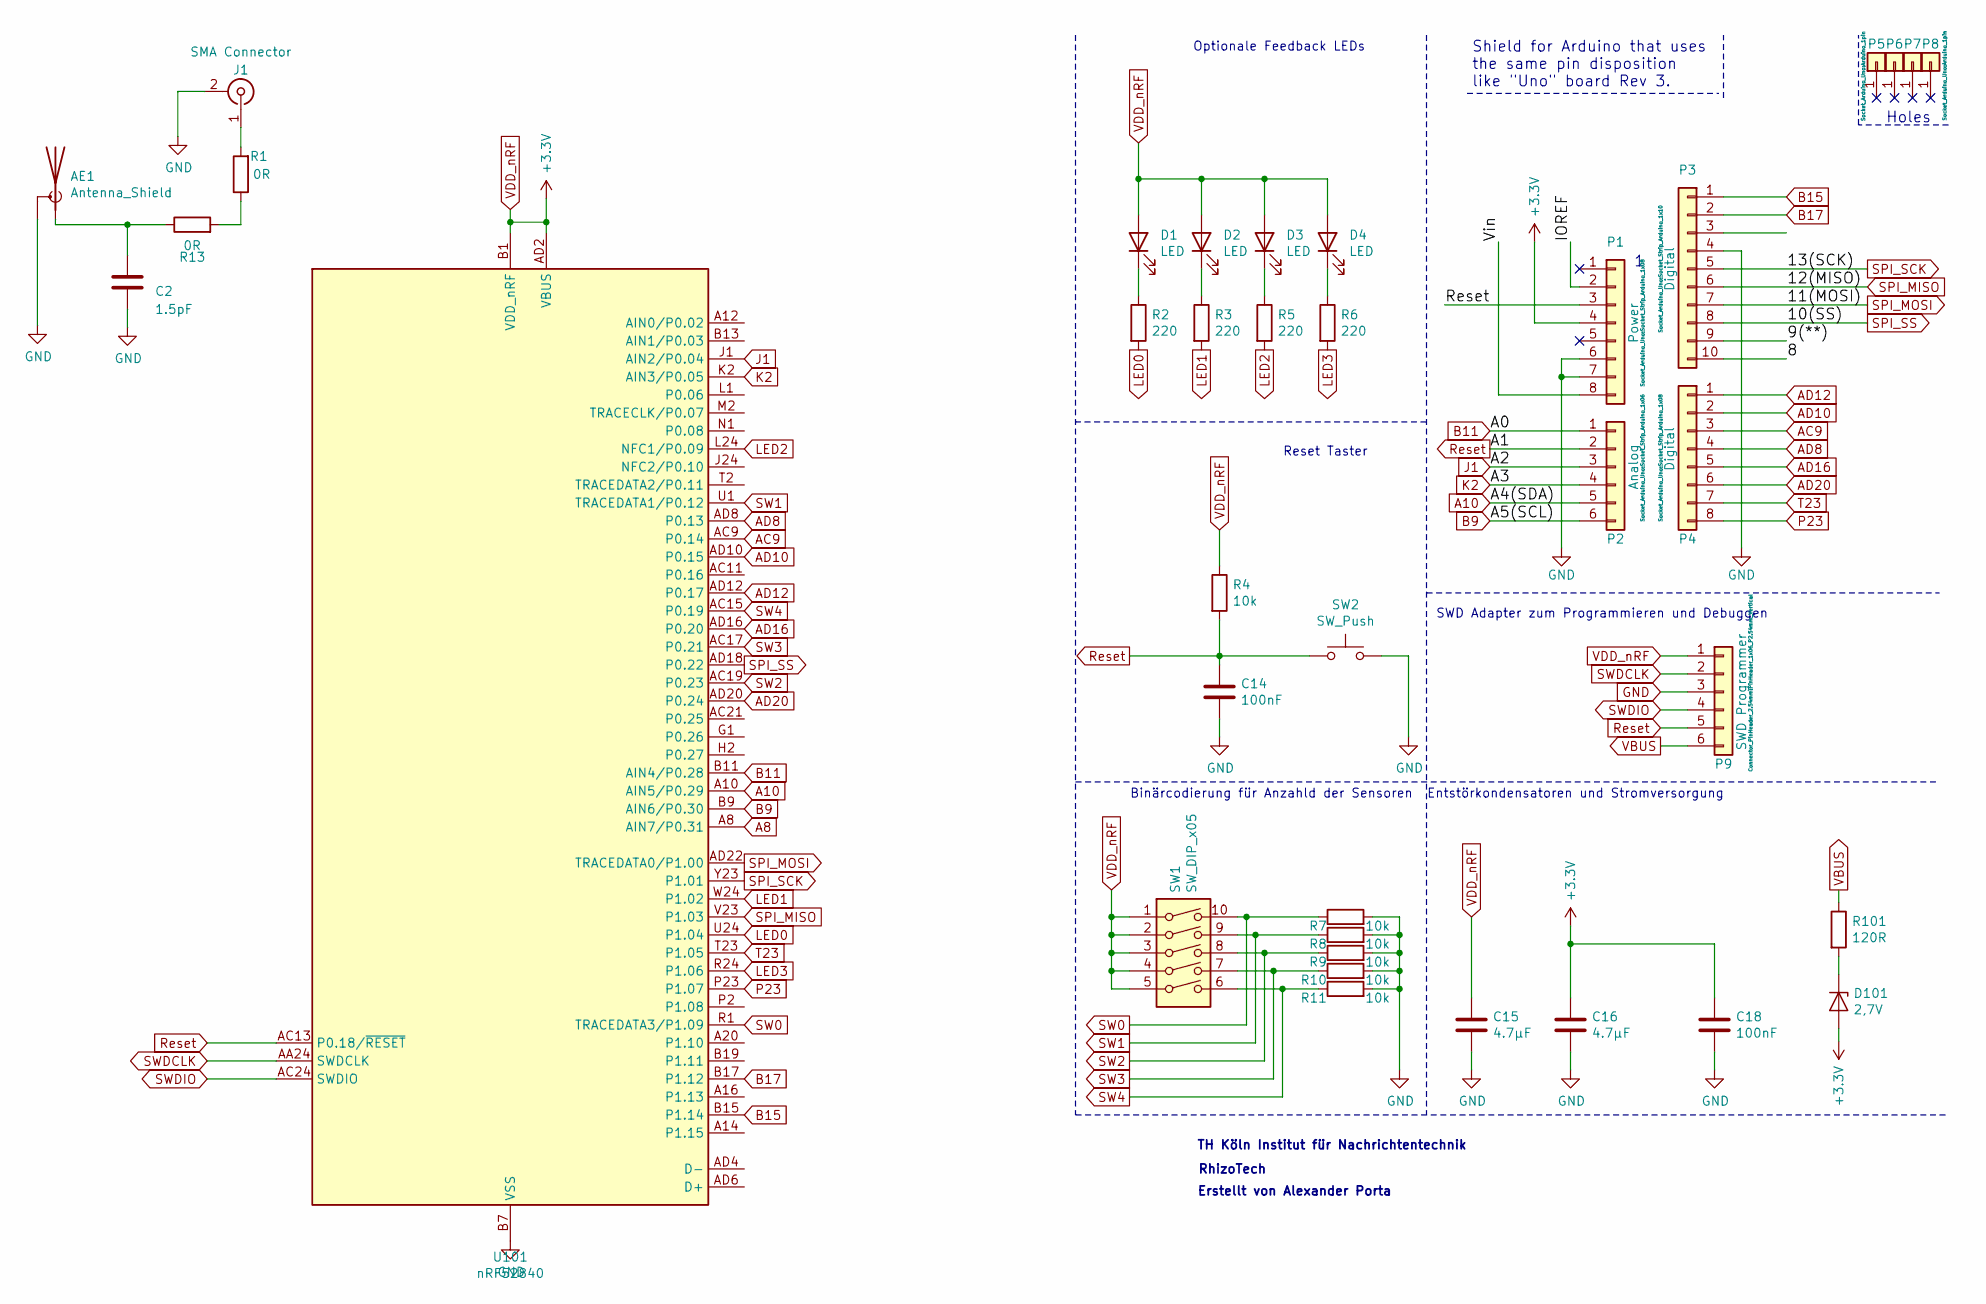
[picture p38: schematic Rhizo_Receiver_Shield_V2.sch, Motherboard_Receiver_Shield_nRF52840]

Parts:
AE1: Antenna_Shield; Texas_SWRA117D_2.4GHz_Left
C2: 1.5pF; C_0603_1608Metric_Pad1.08x0.95mm_HandSolder
C14, C18: 100nF; C_0603_1608Metric_Pad1.08x0.95mm_HandSolder
C15, C16: 4.7µF; C_0603_1608Metric_Pad1.08x0.95mm_HandSolder
D1, D2, D3, D4: LED; LED_0603_1608Metric
D101: 2,7V; D_0603_1608Metric
J1: SMA Connector; U.FL_Hirose_U.FL-R-SMT-1_Vertical
P1: Power; Socket_Strip_Arduino_1x08
P2: Analog; Socket_Strip_Arduino_1x06
P3: Digital; Socket_Strip_Arduino_1x10
P4: Digital; Socket_Strip_Arduino_1x08
P5, P6, P7, P8: CONN_01X01; Arduino_1pin
P9: SWD Programmer; PinHeader_1x06_P2.54mm_Vertical
R1, R13: 0R; R_0603_1608Metric
R2, R3, R5, R6: 220; R_0603_1608Metric
R4, R7, R8, R9, R10, R11: 10k; R_0603_1608Metric
R101: 120R; R_0603_1608Metric
SW1: SW_DIP_x05; SW_DIP_SPSTx05_Slide_6.7x14.26mm_W6.73mm_P2.54mm_LowProfile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
SW2: SW_Push; SW_SPST_EVQQ2
U101: nRF52840; Waveshare_nRF528840

Connections:
/8: P3.10
/9(**): P3.9
/IOREF: P1.2
/Vin: P1.8
A8: U101.A8 (AIN7/P0.31)
A10: P2.5, U101.A10 (AIN5/P0.29)
AC9: P4.3, U101.AC9 (P0.14)
AD8: P4.4, U101.AD8 (P0.13)
AD10: P4.2, U101.AD10 (P0.15)
AD12: P4.1, U101.AD12 (P0.17)
AD16: P4.5, U101.AD16 (P0.20)
AD20: P4.6, U101.AD20 (P0.24)
B9: P2.6, U101.B9 (AIN6/P0.30)
B11: P2.1, U101.B11 (AIN4/P0.28)
B15: P3.1, U101.B15 (P1.14)
B17: P3.2, U101.B17 (P1.12)
GND: AE1.2 (Shield), C2.2, C14.2, C15.2, C16.2, C18.2, J1.2 (Ext), P1.6, P1.7, P3.4, P9.3, R7.2, R8.2, R9.2, R10.2, R11.2, SW2.2, U101.B7 (VSS)
J1: P2.3, U101.J1 (AIN2/P0.04)
K2: P2.4, U101.K2 (AIN3/P0.05)
LED0: R2.2, U101.U24 (P1.04)
LED1: R3.2, U101.W24 (P1.02)
LED2: R5.2, U101.L24 (NFC1/P0.09)
LED3: R6.2, U101.R24 (P1.06)
unnamed: AE1.1 (A), C2.1, R13.1
unnamed: D1.1 (K), R2.1
unnamed: D2.1 (K), R3.1
unnamed: D3.1 (K), R5.1
unnamed: D4.1 (K), R6.1
unnamed: D101.1 (K), R101.2
unnamed: J1.1 (In), R1.2
unnamed: R1.1, R13.2
P23: P4.8, U101.P23 (P1.07)
Reset: C14.1, P1.3, P2.2, P9.5, R4.2, SW2.1, U101.AC13 (P0.18/~RESET)
SPI_MISO: P3.6, U101.V23 (P1.03)
SPI_MOSI: P3.7, U101.AD22 (TRACEDATA0/P1.00)
SPI_SCK: P3.5, U101.Y23 (P1.01)
SPI_SS: P3.8, U101.AD18 (P0.22)
SW0: R7.1, SW1.10, U101.R1 (TRACEDATA3/P1.09)
SW1: R8.1, SW1.9, U101.U1 (TRACEDATA1/P0.12)
SW2: R9.1, SW1.8, U101.AC19 (P0.23)
SW3: R10.1, SW1.7, U101.AC17 (P0.21)
SW4: R11.1, SW1.6, U101.AC15 (P0.19)
SWDCLK: P9.2, U101.AA24 (SWDCLK)
SWDIO: P9.4, U101.AC24 (SWDIO)
T23: P4.7, U101.T23 (P1.05)
VBUS: P9.6, R101.1
VDD_nRF: C15.1, C16.1, C18.1, D1.2 (A), D2.2 (A), D3.2 (A), D4.2 (A), D101.2 (A), P1.4, P9.1, R4.1, SW1.1, SW1.2, SW1.3, SW1.4, SW1.5, U101.AD2 (VBUS), U101.B1 (VDD_nRF)

Notes on the sheet:
Binärcodierung für Anzahld der Sensoren
Optionale Feedback LEDs
TH Köln Institut für Nachrichtentechnik
Erstellt von Alexander Porta
RhizoTech
Reset Taster
Entstörkondensatoren und Stromversorgung
SWD Adapter zum Programmieren und Debuggen
Shield for Arduino that uses the same pin disposition like "Uno" board Rev 3.
Holes

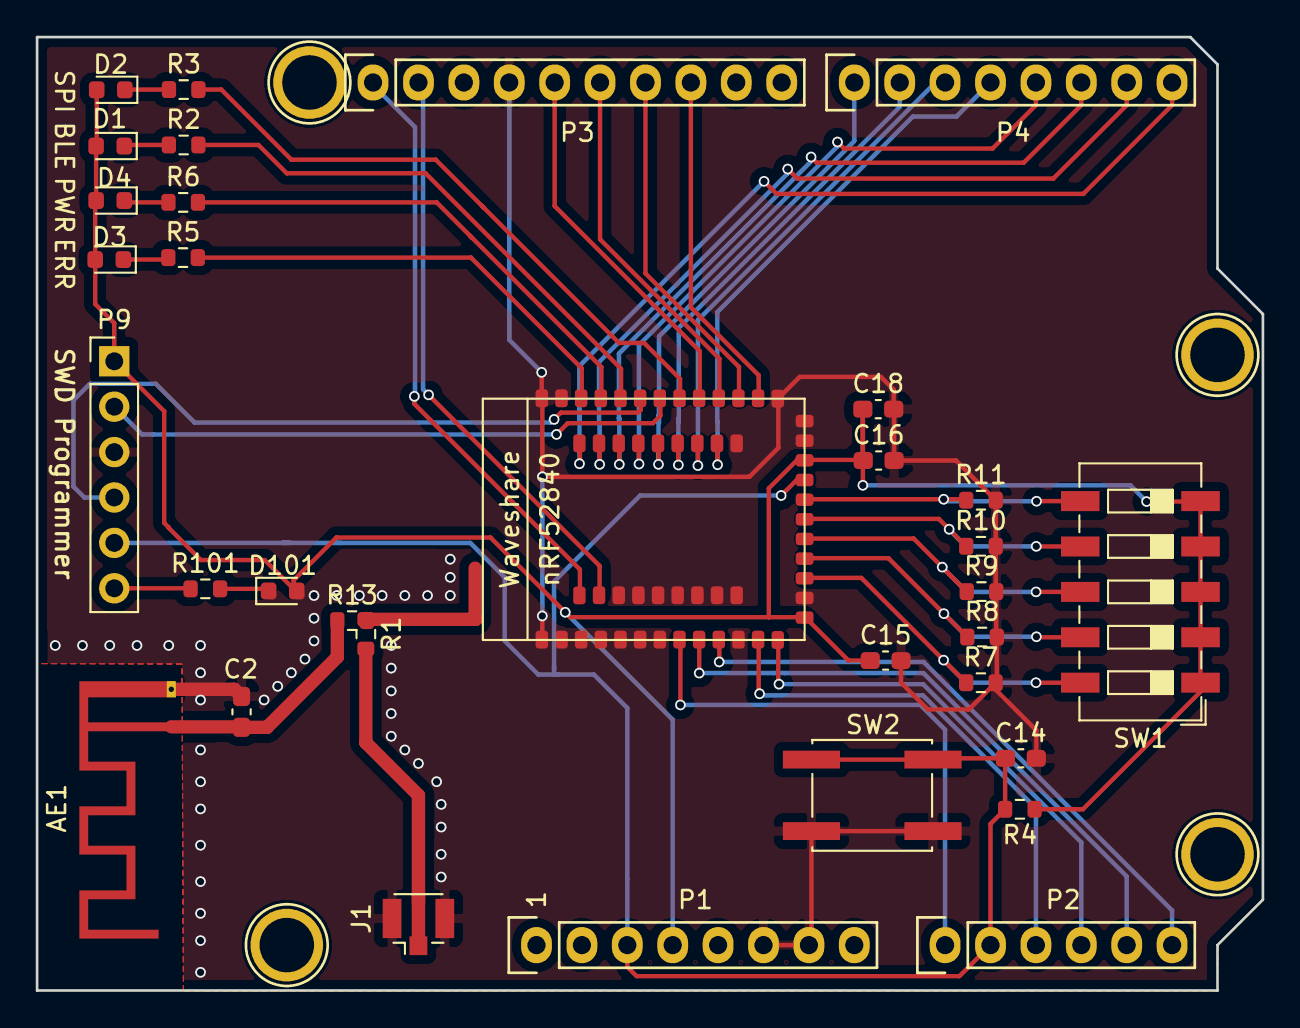
[picture p39: board Rhizo_Receiver_Shield_V2.kicad_pcb from above]

Board: 2 copper layers, 68.6 x 53.3 mm, 37 parts (0 on the bottom side), 42 nets.
