dettmaru/Release/Hardware/Waveshare Module Small V3.0 /Waveshare Module Small V3.0.kicad_pcb

## KiCad design Hardware/Waveshare Module Small V3.0 /Waveshare Module Small V3.0.kicad_pcb (2022-01-10)

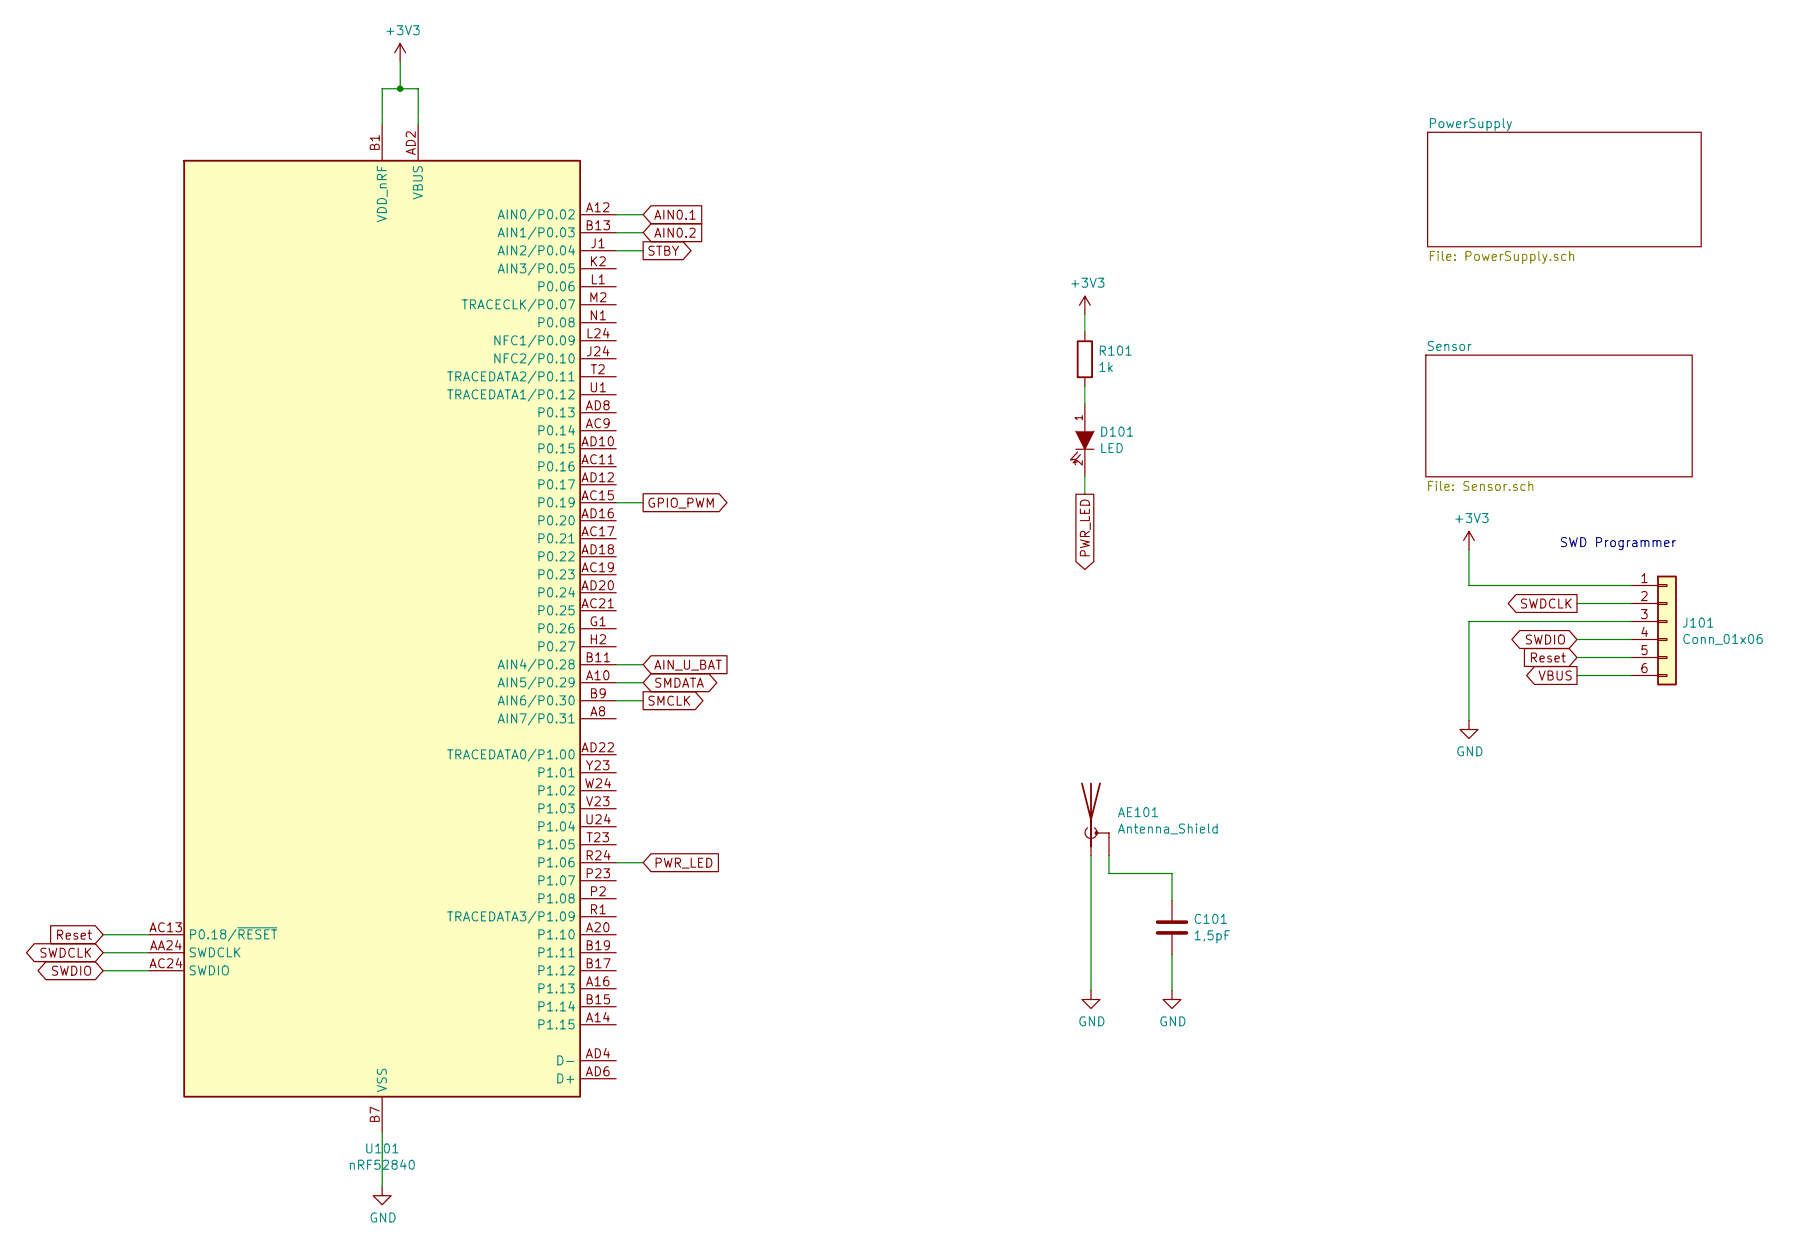
[picture p40: schematic Waveshare Module Small V3.0.sch]

Parts:
AE101: Antenna_Shield; Texas_SWRA117D_2.4GHz_Right
C101: 1,5pF; C_0603_1608Metric_Pad1.08x0.95mm_HandSolder
D101: LED; LED_0603_1608Metric_Pad1.05x0.95mm_HandSolder
J101: Conn_01x06; PinHeader_1x06_P2.54mm_Vertical
R101: 1k; R_0603_1608Metric_Pad0.98x0.95mm_HandSolder
U101: nRF52840; Waveshare_nRF528840

Connections:
+3V3: J101.1, R101.1, U101.AD2 (VBUS), U101.B1 (VDD_nRF); also elsewhere on the board
AIN0.1: U101.A12 (AIN0/P0.02); also elsewhere on the board
AIN0.2: U101.B13 (AIN1/P0.03); also elsewhere on the board
AIN_U_BAT: U101.B11 (AIN4/P0.28); also elsewhere on the board
GND: AE101.1 (A), C101.2, J101.3, U101.B7 (VSS); also elsewhere on the board
GPIO_PWM: U101.AC15 (P0.19); also elsewhere on the board
unnamed: AE101.2 (Shield), C101.1
unnamed: D101.1 (A), R101.2
PWR_LED: D101.2 (K), U101.R24 (P1.06)
Reset: J101.5, U101.AC13 (P0.18/~RESET)
SMCLK: U101.B9 (AIN6/P0.30); also elsewhere on the board
SMDATA: U101.A10 (AIN5/P0.29); also elsewhere on the board
STBY: U101.J1 (AIN2/P0.04); also elsewhere on the board
SWDCLK: J101.2, U101.AA24 (SWDCLK)
SWDIO: J101.4, U101.AC24 (SWDIO)
VBUS: J101.6

Notes on the sheet:
SWD Programmer

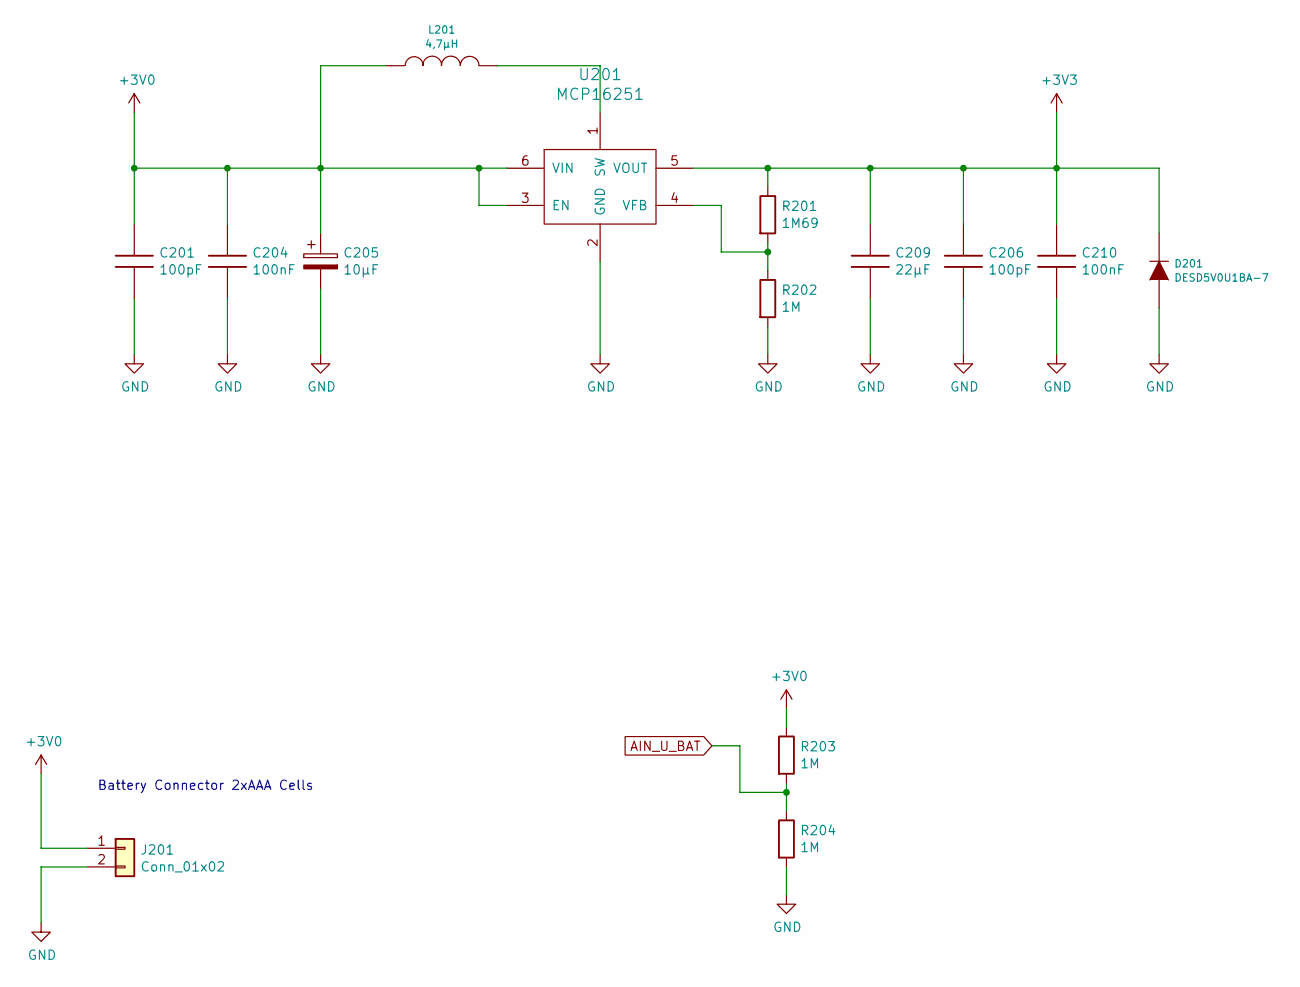
[picture p41: schematic PowerSupply.sch]

Parts:
C201, C206: 100pF; C_0603_1608Metric_Pad1.08x0.95mm_HandSolder
C204, C210: 100nF; C_0603_1608Metric_Pad1.08x0.95mm_HandSolder
C205: 10µF; R_0603_1608Metric_Pad0.98x0.95mm_HandSolder
C209: 22µF; CP_Elec_4x5.4
D201: DESD5V0U1BA-7; D_0603_1608Metric_Pad1.05x0.95mm_HandSolder
J201: Conn_01x02; PinHeader_1x02_P2.54mm_Vertical
L201: 4,7µH; L_Bourns-SRN4018
R201: 1M69; R_0603_1608Metric_Pad0.98x0.95mm_HandSolder
R202, R203, R204: 1M; R_0603_1608Metric_Pad0.98x0.95mm_HandSolder
U201: MCP16251; SOT-23-6_Handsoldering

Connections:
+3V0: C201.1, C204.1, C205.1, J201.1, L201.1, R203.1, U201.3 (EN), U201.6 (VIN)
+3V3: C206.1, C209.1, C210.1, D201.2 (K), R201.1, U201.5 (VOUT); also elsewhere on the board
AIN_U_BAT: R203.2, R204.1; also elsewhere on the board
GND: C201.2, C204.2, C205.2, C206.2, C209.2, C210.2, D201.1 (A), J201.2, R202.2, R204.2, U201.2 (GND); also elsewhere on the board
unnamed: L201.2, U201.1 (SW)
unnamed: R201.2, R202.1, U201.4 (VFB)

Notes on the sheet:
Battery Connector 2xAAA Cells

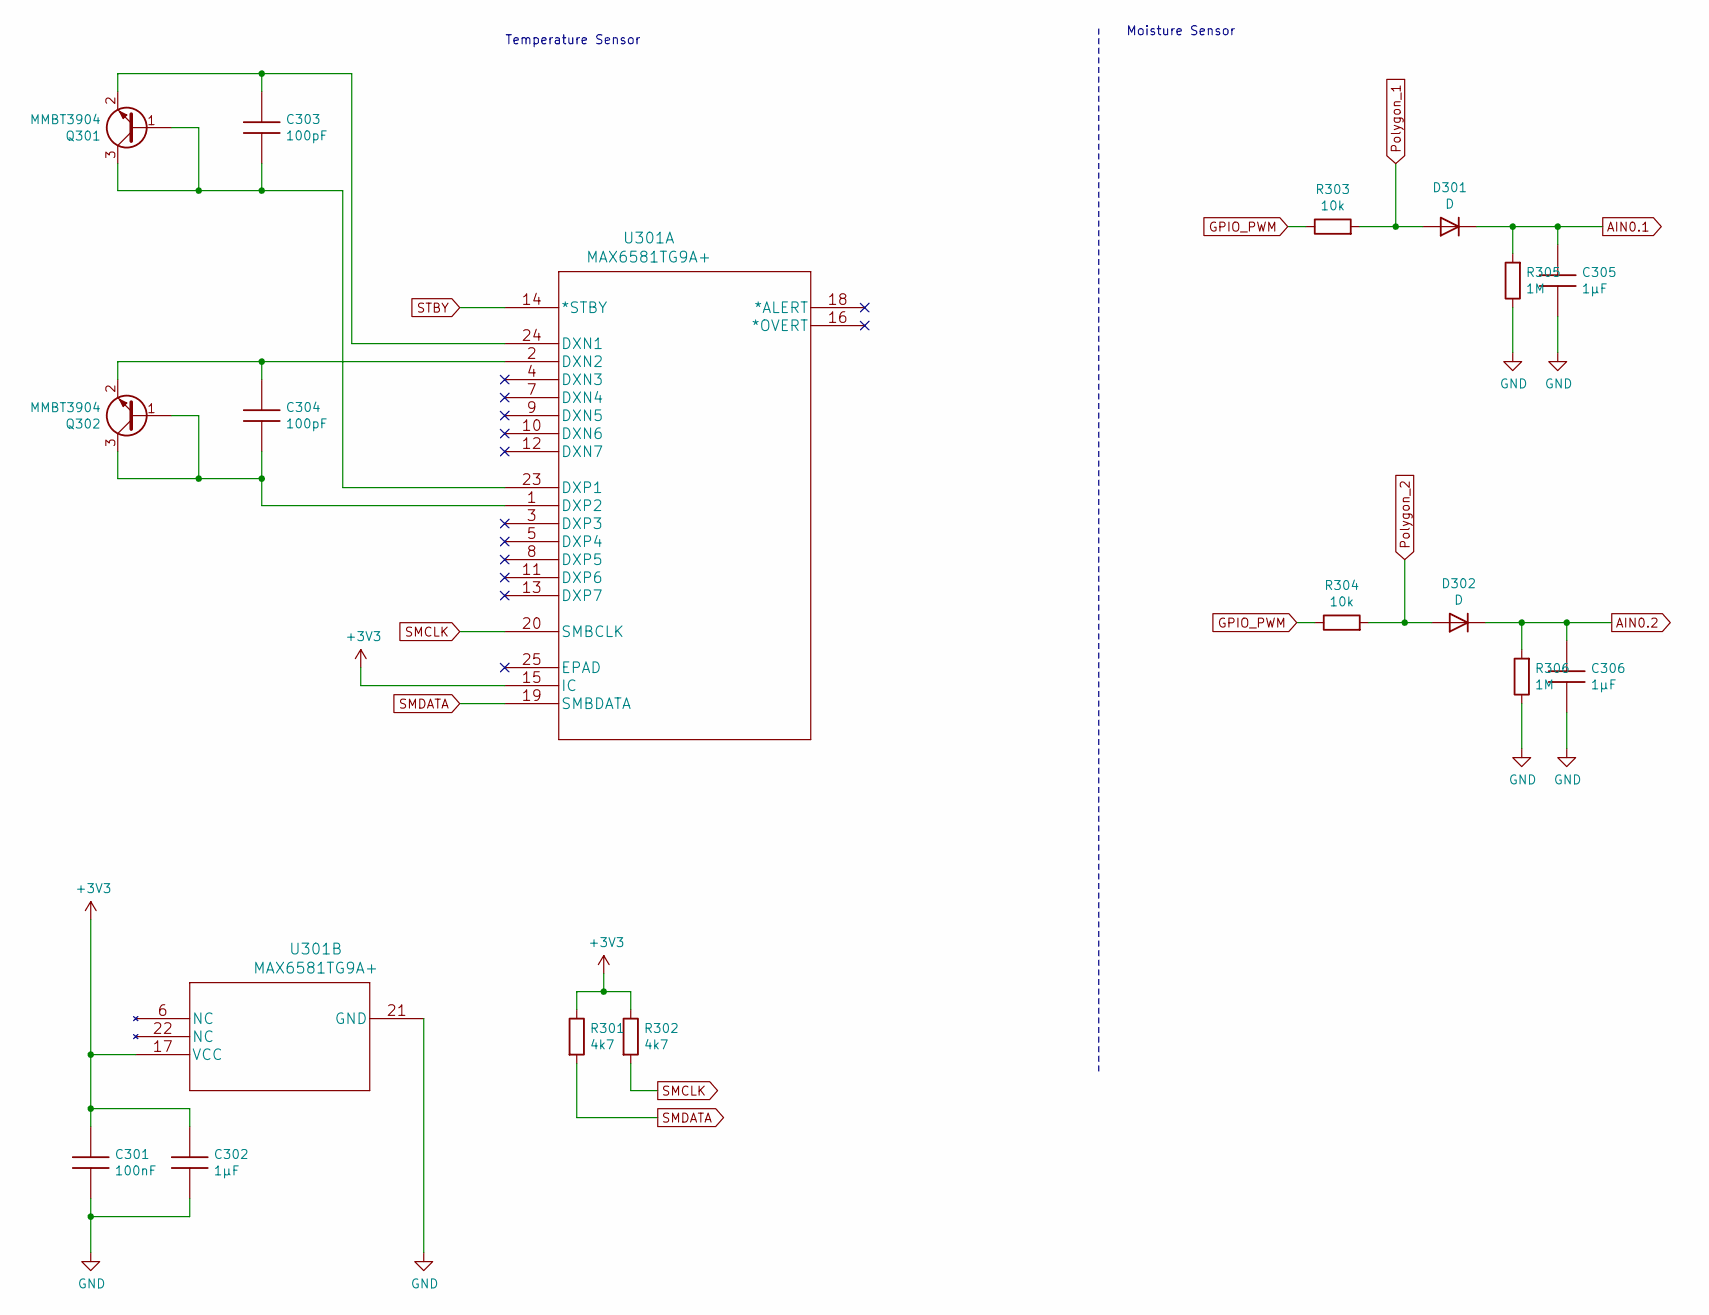
[picture p42: schematic Sensor.sch]

Parts:
C301: 100nF; C_0603_1608Metric_Pad1.08x0.95mm_HandSolder
C302, C305, C306: 1µF; C_0603_1608Metric_Pad1.08x0.95mm_HandSolder
C303, C304: 100pF; C_0603_1608Metric_Pad1.08x0.95mm_HandSolder
D301, D302: D; D_0603_1608Metric_Pad1.05x0.95mm_HandSolder
Q301, Q302: MMBT3904; SOT-23
R301, R302: 4k7; R_0603_1608Metric_Pad0.98x0.95mm_HandSolder
R303, R304: 10k; R_0603_1608Metric_Pad0.98x0.95mm_HandSolder
R305, R306: 1M; R_0603_1608Metric_Pad0.98x0.95mm_HandSolder
U301: MAX6581TG9A+; HVQFN-24-1EP_4x4mm_P0.5mm_EP2.5x2.5mm

Connections:
+3V3: C301.1, C302.1, R301.1, R302.1, U301.15 (IC), U301.17 (VCC); also elsewhere on the board
AIN0.1: C305.1, D301.1 (K), R305.2; also elsewhere on the board
AIN0.2: C306.1, D302.1 (K), R306.2; also elsewhere on the board
GND: C301.2, C302.2, C305.2, C306.2, R305.1, R306.1, U301.21 (GND); also elsewhere on the board
GPIO_PWM: R303.1, R304.1; also elsewhere on the board
unnamed: C303.1, Q301.2 (E), U301.24 (DXN1)
unnamed: C303.2, Q301.1 (B), Q301.3 (C), U301.23 (DXP1)
unnamed: C304.1, Q302.2 (E), U301.2 (DXN2)
unnamed: C304.2, Q302.1 (B), Q302.3 (C), U301.1 (DXP2)
Polygon_1: D301.2 (A), R303.2
Polygon_2: D302.2 (A), R304.2
SMCLK: R302.2, U301.20 (SMBCLK); also elsewhere on the board
SMDATA: R301.2, U301.19 (SMBDATA); also elsewhere on the board
STBY: U301.14 (*STBY); also elsewhere on the board

Notes on the sheet:
Moisture Sensor
Temperature Sensor

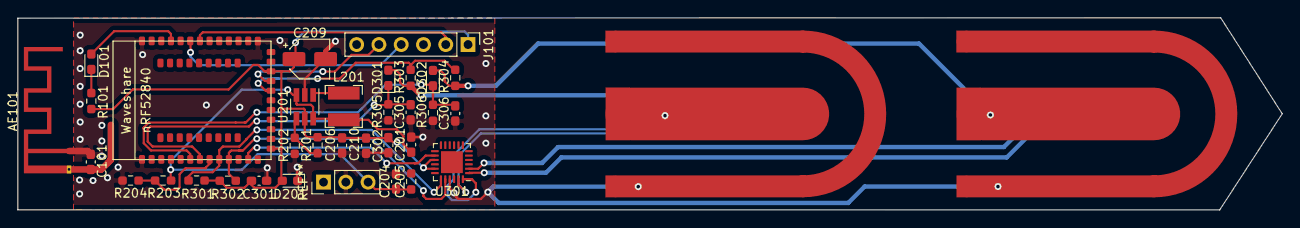
[picture p43: board Waveshare Module Small V3.0.kicad_pcb from above]

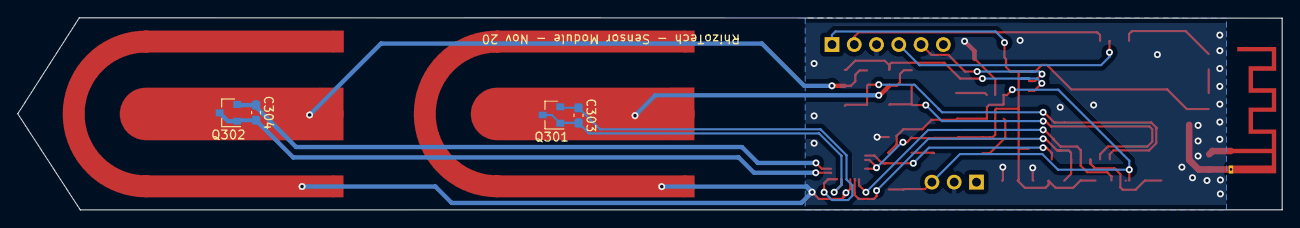
[picture p44: board Waveshare Module Small V3.0.kicad_pcb from below]

Board: 2 copper layers, 144.1 x 21.9 mm, 36 parts (4 on the bottom side), 24 nets.
