dettmaru/Release/Hardware/BaseCircuit_V3/BaseCircuit_V2.kicad_pcb

## KiCad design Hardware/BaseCircuit_V3/BaseCircuit_V2.kicad_pcb (2022-01-10, an earlier design)

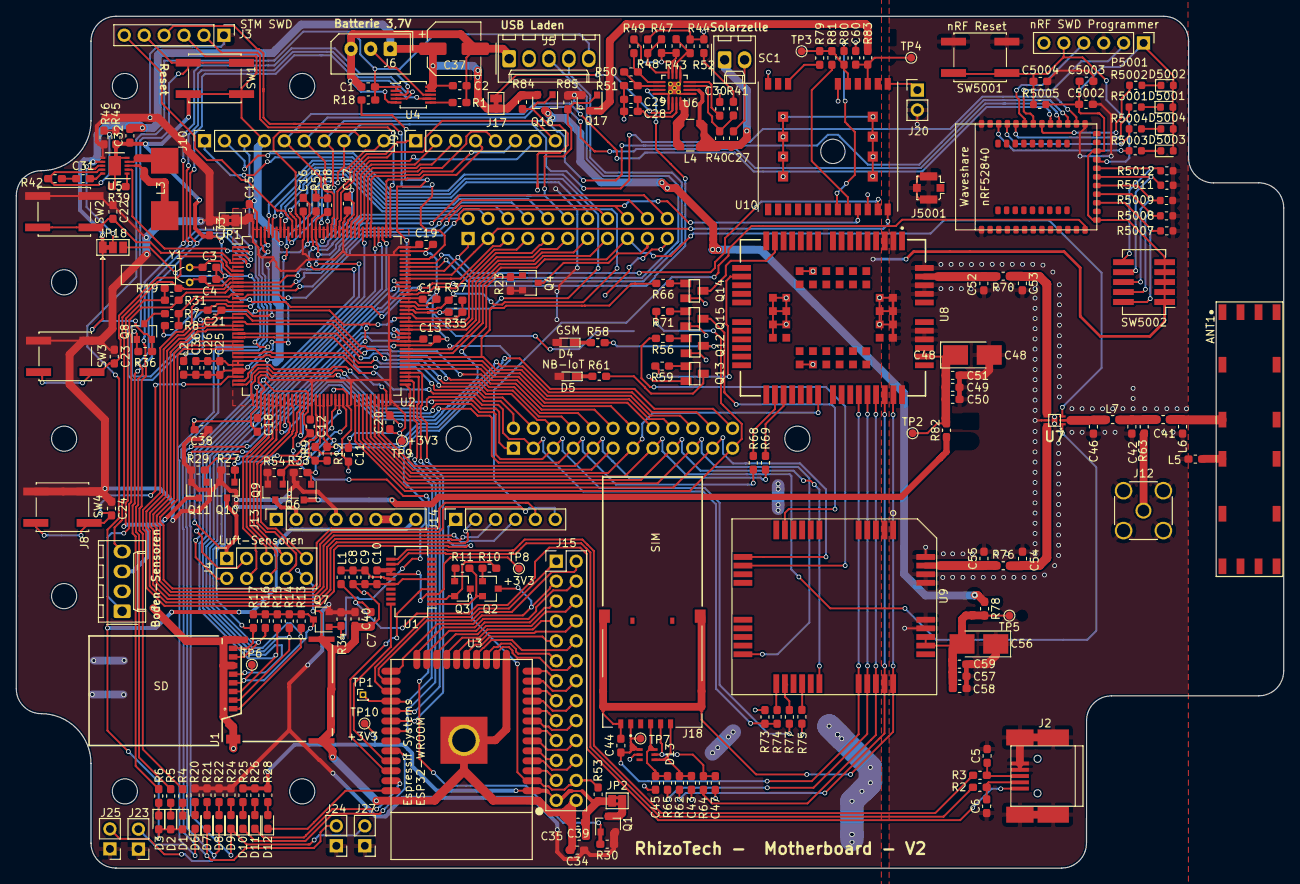
[picture p45: board BaseCircuit_V2.kicad_pcb from above]

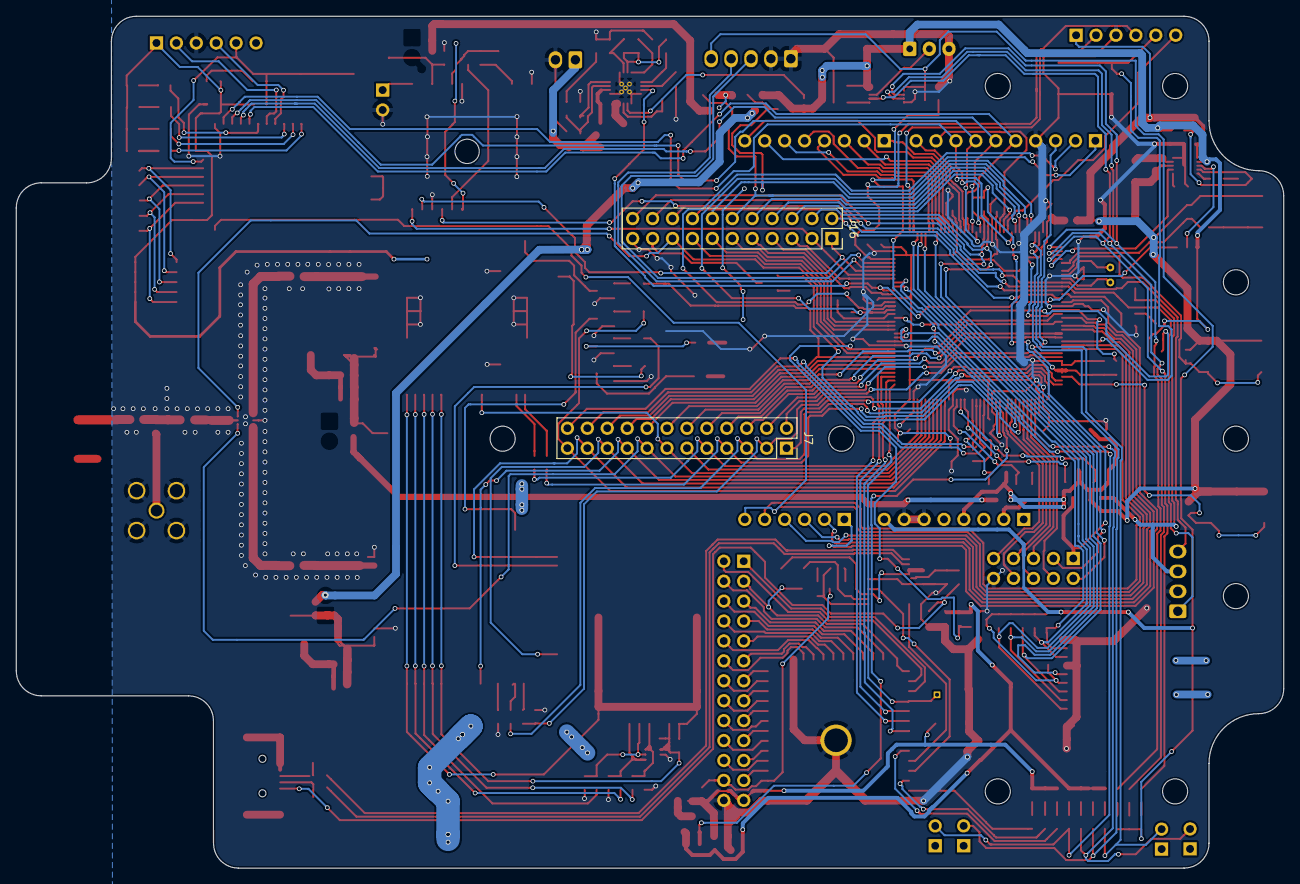
[picture p46: board BaseCircuit_V2.kicad_pcb from below]

Board: 2 copper layers, 161.6 x 108.6 mm, 259 parts (2 on the bottom side), 259 nets.

Parts:
ANT1: Lucida; Antenova_Lucida
C1, C2, C25: 1µ; C_0603_1608Metric_Pad1.05x0.95mm_HandSolder
C3, C4: 4p7; C_0603_1608Metric_Pad1.05x0.95mm_HandSolder
C5, C6: 47p; C_0603_1608Metric_Pad1.05x0.95mm_HandSolder
C7, C28, C30, C36: 10n; C_0603_1608Metric_Pad1.05x0.95mm_HandSolder
C8, C10, C11, C12, C13, C14, C15, C16, C17, C18, C19, C20, C21, C22, C23, C24, C26, C31, C35, C44, C49, C57, C60: 100n; C_0603_1608Metric_Pad1.05x0.95mm_HandSolder
C9, C27, C29: 4µ7; C_0603_1608Metric_Pad1.05x0.95mm_HandSolder
C32: 10µ; C_0603_1608Metric_Pad1.05x0.95mm_HandSolder
C33, C34, C38, C39, C40: 22µ; C_0603_1608Metric_Pad1.05x0.95mm_HandSolder
C37: 470µ; CP_Elec_6.3x7.7
C41: 2p2; C_0603_1608Metric_Pad1.05x0.95mm_HandSolder
C42: Not fitted; C_0603_1608Metric_Pad1.05x0.95mm_HandSolder
C43, C45, C47, C59: 33p; C_0603_1608Metric_Pad1.05x0.95mm_HandSolder
C46: 0p5; C_0603_1608Metric_Pad1.05x0.95mm_HandSolder
C48, C56: 100µ; Tantal_Cap_100u
C50: 100p; C_0603_1608Metric_Pad1.05x0.95mm_HandSolder
C51: 22p; C_0603_1608Metric_Pad1.05x0.95mm_HandSolder
C52, C53, C54, C55: NM; C_0603_1608Metric_Pad1.05x0.95mm_HandSolder
C58: 10p; C_0603_1608Metric_Pad1.05x0.95mm_HandSolder
C5002: 4.7µF; C_0603_1608Metric_Pad1.05x0.95mm_HandSolder
C5003, C5004: 100nF; C_0603_1608Metric_Pad1.05x0.95mm_HandSolder
D1, D2, D8, D10: Rot; LED_0603_1608Metric_Pad1.05x0.95mm_HandSolder
D3, D9, D11: Grün; LED_0603_1608Metric_Pad1.05x0.95mm_HandSolder
D4: GSM_NET; GSM_LED
D5: NB-IoT_NET; NB-IoT_LED
D6, D7, D12: Gelb; LED_0603_1608Metric_Pad1.05x0.95mm_HandSolder
D13: SMF05C.TCT; SC70-6
D5001, D5002, D5003, D5004: LED; LED_0603_1608Metric
H6, H7, H8, H9, H10, H11, H12, H13, H14: MountingHole; MountingHole_3.2mm_M3
J1: Micro_SD_Card; 503398-1892
J2: USB B mini; USB_Mini-B
J3: CONN_01X06; PinHeader_1x06_P2.54mm_Vertical
J4: Conn_2x5_Temp; PinHeader_2x05_P2.54mm_Vertical
J5: Conn_01x05; Molex_KK-254_AE-6410-05A_1x05_P2.54mm_Vertical
J6: CONN_01X03; Molex_SPOX_5267-03A_1x03_P2.50mm_Vertical
J7: Conn_02x12_Odd_Even; PinSocket_2x12_P2.54mm_Vertical
J8: Conn_1x4_Soil; Molex_KK-254_AE-6410-04A_1x04_P2.54mm_Vertical
J9, J13: Conn_01x08; PinSocket_1x08_P2.54mm_Vertical
J10: Conn_01x10; PinSocket_1x10_P2.54mm_Vertical
J12: Conn_Coaxial; SMA_Amphenol_132134_Vertical
J14: Conn_01x06; PinSocket_1x06_P2.54mm_Vertical
J15: Conn_02x13_ESP; PinHeader_2x13_P2.54mm_Vertical
J16: Conn_02x11_Odd_Even; PinSocket_2x11_P2.54mm_Vertical
J17: GS2; SolderJumper-2_P1.3mm_Bridged_Pad1.0x1.5mm
J18: Micro-SIM; CONN_78646-3001
J20, J23, J24, J25, J27: Conn_01x02_Male; PinHeader_1x02_P2.54mm_Vertical
J5001: SMA Connector; U.FL_Molex_MCRF_73412-0110_Vertical
JP1: STM Bridge; SolderJumper-2_P1.3mm_Bridged2Bar_Pad1.0x1.5mm
JP2: ESP Bridge; SolderJumper-2_P1.3mm_Bridged2Bar_Pad1.0x1.5mm
JP18: SolderJumper_3_Bridged12; SolderJumper-3_P1.3mm_Bridged12_Pad1.0x1.5mm
L1, L2: Ferrite_Bead; L_0603_1608Metric_Pad1.05x0.95mm_HandSolder
L3: 10µ; MGV0603100M
L4: 22µ; L_Coilcraft_LPS4018
L5, L6: 15n; L_0603_1608Metric_Pad1.05x0.95mm_HandSolder
L7: 3n3; L_0603_1608Metric_Pad1.05x0.95mm_HandSolder
P5001: SWD Programmer; PinHeader_1x06_P2.54mm_Vertical
Q1, Q4, Q6, Q7, Q8, Q9, Q10, Q11, Q16, Q17: DMP2170; SOT-23
Q2, Q3: MMBT2222; SOT-23
Q12, Q13, Q14, Q15: MMBT2222A; SOT23
R1, R4, R5, R6, R7, R8, R18, R19, R20, R21, R22, R24, R25, R26, R28, R31, R58, R61, R68, R69, R74, R77: 1k; R_0603_1608Metric_Pad1.05x0.95mm_HandSolder
R2, R3: 27R; R_0603_1608Metric_Pad1.05x0.95mm_HandSolder
R9, R12, R35, R37, R38, R55, R56, R59, R66, R71: 4k7; R_0603_1608Metric_Pad1.05x0.95mm_HandSolder
R10, R11, R53, R79: 10k; R_0603_1608Metric_Pad1.05x0.95mm_HandSolder
R13, R14, R15, R16, R17: 47k; R_0603_1608Metric_Pad1.05x0.95mm_HandSolder
R23, R27, R29, R30, R33, R34, R36, R54, R84, R85: 1M; R_0603_1608Metric_Pad1.05x0.95mm_HandSolder
R39: 60k4; R_0603_1608Metric_Pad1.05x0.95mm_HandSolder
R40: 3M32; R_0603_1608Metric_Pad1.05x0.95mm_HandSolder
R41: 10M; R_0603_1608Metric_Pad1.05x0.95mm_HandSolder
R42: 15k; R_0603_1608Metric_Pad1.05x0.95mm_HandSolder
R43: 5M49; R_0603_1608Metric_Pad1.05x0.95mm_HandSolder
R44: 4M42; R_0603_1608Metric_Pad1.05x0.95mm_HandSolder
R45: 200k; R_0603_1608Metric_Pad1.05x0.95mm_HandSolder
R46: 340k; R_0603_1608Metric_Pad1.05x0.95mm_HandSolder
R47, R48: 4M99; R_0603_1608Metric_Pad1.05x0.95mm_HandSolder
R49: 1M73; R_0603_1608Metric_Pad1.05x0.95mm_HandSolder
R50: 3M92; R_0603_1608Metric_Pad1.05x0.95mm_HandSolder
R51: 4M32; R_0603_1608Metric_Pad1.05x0.95mm_HandSolder
R52: 6M65; R_0603_1608Metric_Pad1.05x0.95mm_HandSolder
R62, R64, R65: 22R; R_0603_1608Metric_Pad1.05x0.95mm_HandSolder
R63, R70, R75, R76, R78, R82, R83: 0R; R_0603_1608Metric_Pad1.05x0.95mm_HandSolder
R73: 5k6; R_0603_1608Metric_Pad1.05x0.95mm_HandSolder
R80, R81: 2k2; R_0603_1608Metric_Pad1.05x0.95mm_HandSolder
R5001, R5002, R5003, R5004: 220; R_0603_1608Metric
R5005, R5007, R5008, R5009, R5011, R5012: 10k; R_0603_1608Metric
SC1: Solar_Cell; Molex_KK-254_AE-6410-02A_1x02_P2.54mm_Vertical
SW1, SW2, SW3, SW4, SW5001: SW_Push; SW_SPST_EVQQ2
SW5002: SW_DIP_x05; SW_DIP_SPSTx05_Slide_KingTek_DSHP05TJ_W5.25mm_P1.27mm_JPin
TP1: SE_REA; PinHeader_1x01_P1.00mm_Vertical
TP2, TP4, TP8, TP9, TP10: +3V3; TestPoint_Pad_D1.0mm
TP3: +1V8; TestPoint_Pad_D1.0mm
TP5: +VBATT; TestPoint_Pad_D1.0mm
TP6: U_SD; TestPoint_Pad_D1.0mm
TP7: U_SIM; TestPoint_Pad_D1.0mm
U1: FT231XS; SSOP-20_3.9x8.7mm_P0.635mm
U2: STM32L496Zx; TQFP-144_20x20mm_P0.5mm
U3: ESP32-WROOM
U4: MCP73833; MSOP-10_3x3mm_P0.5mm
U5: LTC3440; DFN-10-1EP_3x3mm_P0.5mm_EP1.55x2.48mm
U6: BQ25504; QFN-16-1EP_3x3mm_Pitch0.5mm_ThermalVias_HandSoldering
U7: SKY13370-374LF; SKY13370_374LF
U8: BC95G; BC95-B8
U9: M95; XCVR_M95
U10: A2235-H; XCVR_A2235-H
U5001: nRF52840; Waveshare_nRF528840
Y1: 32.768kHz; Crystal_C26-LF_D2.1mm_L6.5mm_Horizontal

Connections:
1V8: R79.2, R80.2, R81.2, TP3.1, U10.5
+3.3VP: C10.1, TP8.1, U1.3, U1.13, U1.14
+5VL: C1.2, D1.2, D2.2, D3.2, J5.5, J13.8, R18.1, U4.1, U4.2
+5VP: C8.1, C9.1, L1.2, U1.15
+BATT: C2.1, C32.2, C37.1, J6.1, J17.1, JP18.1, Q8.2, Q16.2, R36.1, R84.1, U4.9, U4.10, U5.7
/BT1: C22.2, SW2.2, U2.5
/BT2: C23.2, SW3.2, U2.7
/BT3: C24.2, SW4.2, U2.34
/CLK: J15.8, U3.20
/CMD: J15.9, U3.19
/D_LOAD+: J5.3, U2.104
/D_LOAD-: J5.4, U2.103
/ESP_GPIO0: J15.3, Q2.3, U3.25
/ESP_ON: Q1.1, R30.2, U2.49
/ESP_RESET: J15.24, Q3.3, R53.1, U3.3
/ESP_RXD0: U1.20, U3.34
/ESP_TXD0: U1.4, U3.35
/IO2: J15.4, U3.24
/IO4: J15.2, U3.26
/IO5: U2.75, U3.29
/IO12: J15.13, U3.14
/IO13: J15.12, U3.16
/IO14: J15.14, U3.13
/IO15: J15.5, U3.23
/IO16: J15.1, U3.27
/IO17: TP1.1, U2.73, U3.28
/IO18: U2.76, U3.30
/IO19: U2.74, U3.31
/IO21: D10.1, U3.33
/IO22: D11.1, U3.36
/IO23: D12.1, U3.37
/IO25: J15.17, U3.10
/IO26: J15.16, U3.11
/IO27: J15.15, U3.12
/IO32: J15.19, U3.8
/IO33: J15.18, U3.9
/IO34: J15.21, U3.6
/IO35: J15.20, U3.7
/Interfaces/+5V_ESP: C7.1, J2.1, L1.1
/Interfaces/D+_ESP: C5.1, J2.3, R3.2
/Interfaces/D-_ESP: C6.1, J2.2, R2.2
/Interfaces/DTR: Q2.2, R11.2, U1.1
/Interfaces/RTS: Q3.2, R10.2, U1.2
/LED1: D6.1, J23.2, U2.141
/LED2: D7.1, J24.2, U2.142
/LED3: D8.1, J25.2, U2.85
/LED4: D9.1, J27.2, U2.86
/LOAD_PG: R6.2, U2.3, U4.7
/LOAD_STAT1: R4.2, U2.1, U4.3
/LOAD_STAT2: R5.2, U2.2, U4.4
/MODE_SYNC: U2.4, U5.2
/NRST: J3.5, SW1.1, U2.25
/PA1: J7.1, U2.35
/PA4: J4.4, U2.40
/PA5: J4.5, U2.41
/PA6: J4.6, U2.42
/PA7: J4.7, U2.43
/PA8: J16.5, U2.100
/PA15: J9.4, U2.110
/PB0: J4.8, U2.46
/PB1: J4.9, U2.47
/PB3: J16.6, U2.133
/PB5: J10.10, U2.135
/PB6: J16.8, U2.136
/PB7: J16.10, U2.137
/PB8: J16.12, Q17.1, R85.2, U2.139
/PB9: J16.14, Q16.1, R84.2, U2.140
/PB10: J7.11, U2.69
/PC1: J14.5, U2.27
/PC2: J7.4, U2.28
/PC3: J7.2, U2.29
/PC5: R18.2, U2.45
/PC6: J16.7, U2.96
/PC7: JP18.3, U2.97, U6.11
/PC8: J1.7, R16.2, U2.98
/PC9: J1.8, R17.2, U2.99
/PC10: J1.1, R13.2, U2.111
/PC11: J1.2, R14.2, U2.112
/PC12: J1.5, U2.113
/PD0: J9.6, U2.114
/PD1: J9.5, U2.115
/PD2: J1.3, R15.2, U2.116
/PD3: J9.3, U2.117
/PD4: J9.2, U2.118
/PD5: J9.7, U2.119
/PD6: J9.8, U2.122
/PD7: J9.1, U2.123
/PD8: J7.14, U2.77
/PD9: J7.16, U2.78
/PD10: J7.18, U2.79
/PD13: J16.15, Q7.1, R34.2, U2.82
/PE7: Q10.1, R27.2, U2.58
/PE8: Q11.1, R29.2, U2.59
/PE9: Q9.1, R54.2, U2.60
/PF0: J8.4, J16.22, R19.2, U2.10
/PF1: J8.1, J16.20, R31.2, U2.11
/PF3: R7.2, R8.1, U2.13
/PF4: J16.16, U2.14
/PF5: J14.1, U2.15
/PF6: J7.8, U2.18
/PF7: J14.2, U2.19
/PF8: J7.12, U2.20
/PF9: J14.3, U2.21
/PF10: J14.4, U2.22
/PF12: Q4.1, R23.2, U2.50
/PF13: R9.2, R12.2, U2.53
/PF14: J7.24, R9.1, U2.54
/PF15: J7.22, R12.1, U2.55
/PG0: Q6.1, R33.2, U2.56
/PG2: J16.13, U2.87
/PG3: J16.11, U2.88
/PG4: J16.9, U2.89
/PG5: Q8.1, R36.2, U2.90
/PG6: R35.1, R37.1, U2.91
/PG7: J10.1, R35.2, U2.92
/PG8: J10.2, R37.2, U2.93
/PG13: J4.2, J16.2, R38.2, U2.128
/PG14: J4.3, J16.4, R55.2, U2.129
/PG15: J10.9, U2.132
/PH0: J7.10, U2.23
/PH1: J7.6, U2.24
/Powersupply/THERM: J6.2, U4.8
/SD1: J15.6, U3.22
/SD2: J15.11, U3.17
/SD3: J15.10, U3.18
/SDO: J15.7, U3.21
/SENSOR_VN: J15.22, U3.5
/SENSOR_VP: J15.23, U3.4
/SWCLK: J3.2, U2.109
/SWDIO: J3.4, U2.105
/TRACESWO: J3.6, U2.134
/VREF: C25.2, C26.2, C36.2, J10.3, L2.2, U2.32, U2.33
ANT: C46.1, L7.2, U7.2
ANT_BC95: J16.17, U2.81, U7.3
ANT_M95: J7.15, U2.67, U7.1
BC95_NETLIGHT: R59.2, U8.18
BC95_RST: J7.20, R66.2, U2.80
ESP3V3: C35.1, C39.1, J15.25, JP2.2, R25.1, R26.1, R28.1, R53.2, TP10.1, U3.2
GND: C1.1, C2.2, C3.2, C4.2, C5.2, C6.2, C7.2, C8.2, C9.2, C10.2, C11.2, C12.2, C13.2, C14.2, C15.2, C16.2, C17.2, C18.2, C19.2, C20.2, C21.2, C25.1, C26.1, C27.1, C28.2, C29.2, C30.2, C32.1, C33.2, C34.2, C35.2, C36.1, C37.2, C38.2, C39.2, C40.2, C42.2, C43.2, C45.2, C46.2, C47.2, C48.2, C49.2, C50.2, C51.2, C52.2, C53.2, C54.2, C55.2, C56.1, C57.1, C58.1, C59.1, C60.1, C5002.2, C5003.2, C5004.2, D13.2, J1.6, J1.9, J2.4, J2.5, J2.6, J3.3, J4.10, J5.1, J5.2, J6.3, J8.2, J10.4, J12.2, J13.6, J13.7, J15.26, J16.21, J20.2, J5001.2, L5.1, L6.2, P5001.3, Q12.2, Q13.2, Q14.2, Q15.2, R1.2, R8.2, R39.2, R44.2, R45.1, R48.2, R51.2, R52.1, R73.2, R75.2, R5007.2, R5008.2, R5009.2, R5011.2, R5012.2, SC1.2, SW1.2, SW5001.2, U1.6, U1.16, U2.16, U2.30, U2.31, U2.38, U2.51, U2.61, U2.71, U2.83, U2.94, U2.107, U2.120, U2.130, U2.138, U2.143, U3.1, U3.15, U3.38, U3.39, U4.5, U5.5, U6.1, U6.5, U6.12, U6.13, U6.17, U7.5, U7.7, U8.2, U8.43, U8.47, U8.48, U8.51, U8.52, U8.54, U8.59, U8.60, U8.61, U8.62, U8.63, U8.64, U8.65, U8.66, U8.71, U8.72, U8.73, U8.74, U8.81, U8.82, U8.83, U8.92, U8.93, U8.94, U9.35, U9.36, U9.37, U9.38, U9.40, U10.6, U10.9, U10.20, U10.23, U10.24, U10.25, U10.26, U10.27, U10.28, U10.29, U10.30, U5001.B7
GPS_ON_SW: J16.18, U2.12, U10.19
LED0: R5001.2, U5001.U24
LED1: R5002.2, U5001.W24
LED2: R5003.2, U5001.L24
LED3: R5004.2, U5001.R24
M95_DTR: J7.19, U2.65, U9.20
M95_NETLIGHT: R56.2, U9.13
M95_ON_SW: J7.23, R71.2, U2.63
M95_STATUS: J7.21, U2.64, U9.12
unnamed: ANT1.3, C41.2, L6.1
unnamed: ANT1.4, L5.2
unnamed: C3.1, U2.8, Y1.1
unnamed: C4.1, U2.9, Y1.2
unnamed: C27.2, L4.1, R40.1, SC1.1, U6.2
unnamed: C28.1, C29.1, U6.15
unnamed: C30.1, U6.4
unnamed: C31.1, U5.10
unnamed: C31.2, R42.1
unnamed: C41.1, C42.1, L7.1, R63.2
unnamed: C43.1, D13.4, J18.C3, R62.1
unnamed: C45.1, D13.6, J18.C2, R65.1
unnamed: C47.1, D13.5, J18.C7, R64.1
unnamed: C48.1, C49.1, C50.1, C51.1, R82.1, TP2.1, U8.45, U8.46
unnamed: C52.1, R70.2, U8.53
unnamed: C55.1, R76.1, U9.39
unnamed: C56.2, C57.2, C58.2, C59.2, R78.2, TP5.1, U9.33, U9.34
unnamed: C60.2, R83.2, TP4.1, U10.3
unnamed: D1.1, R4.1
unnamed: D2.1, R5.1
unnamed: D3.1, R6.1
unnamed: D4.1, R58.2
unnamed: D5.1, R61.2
unnamed: D6.2, R20.2
unnamed: D7.2, R21.2
unnamed: D8.2, R22.2
unnamed: D9.2, R24.2
unnamed: D10.2, R25.2
unnamed: D11.2, R26.2
unnamed: D12.2, R28.2
unnamed: D5001.1, R5001.1
unnamed: D5002.1, R5002.1
unnamed: D5003.1, R5003.1
unnamed: D5004.1, R5004.1
unnamed: J1.4, Q7.3, R13.1, R14.1, R15.1, R16.1, R17.1, TP6.1
unnamed: J12.1, R63.1
unnamed: J17.2, U6.14
unnamed: J20.1, U10.1
unnamed: JP2.1, Q1.3
unnamed: JP18.2, U5.8
unnamed: L3.1, U5.4
unnamed: L3.2, U5.3
unnamed: L4.2, U6.16
unnamed: Q2.1, R10.1
unnamed: Q3.1, R11.1
unnamed: Q8.3, R7.1
unnamed: Q12.1, R56.1
unnamed: Q12.3, R58.1
unnamed: Q13.1, R59.1
unnamed: Q13.3, R61.1
unnamed: Q14.1, R66.1
unnamed: Q14.3, U8.15
unnamed: Q15.1, R71.1
unnamed: Q15.3, U9.10
unnamed: R1.1, U4.6
unnamed: R2.1, U1.12
unnamed: R3.1, U1.11
unnamed: R39.1, U5.1
unnamed: R40.2, R41.1, U6.3
unnamed: R41.2, R52.2
unnamed: R42.2, R45.2, R46.1, U5.9
unnamed: R43.1, R47.1, R49.1, U6.7
unnamed: R43.2, R44.1, U6.6
unnamed: R47.2, R48.1, U6.8
unnamed: R49.2, R50.1, U6.9
unnamed: R50.2, R51.1, U6.10
unnamed: R68.1, U8.29
unnamed: R69.1, U8.30
unnamed: R74.1, U9.21
unnamed: R75.1, U9.24
unnamed: R77.2, U9.22
unnamed: R79.1, U10.7
unnamed: R80.1, U10.17
unnamed: R81.1, U10.18
PWR_SW1: J13.2, Q9.3
PWR_SW2: Q6.3, R82.2
PWR_SW3: C22.1, C23.1, C24.1, C33.1, C34.1, C38.1, C40.1, C5002.1, C5003.1, D4.2, D5.2, D5001.2, D5002.2, D5003.2, D5004.2, J3.1, J13.4, J23.1, J24.1, J25.1, J27.1, JP1.2, P5001.1, Q1.2, Q4.2, Q6.2, Q7.2, Q9.2, Q10.2, Q11.2, Q17.2, R20.1, R21.1, R22.1, R23.1, R24.1, R27.1, R29.1, R30.1, R33.1, R34.1, R46.2, R54.1, R85.1, R5005.1, SW2.1, SW3.1, SW4.1, SW5002.1, SW5002.2, SW5002.3, SW5002.4, SW5002.5, U5.6, U5001.AD2, U5001.B1
PWR_SW4: J16.19, Q4.3
PWR_SW5: J4.1, Q10.3, R38.1, R55.1
PWR_SW6: J8.3, Q11.3, R19.1, R31.1
PWR_SW7: Q16.3, R78.1
PWR_SW8: Q17.3, R83.1
RF1: C53.1, R70.1, U7.4
RF2: C54.1, R76.2, U7.6
Reset: C5004.1, P5001.5, R5005.2, SW5001.1, U5001.AC13
SMSPIN_BC95: J7.13, U2.68, U8.34
SMSPIN_M95: J7.17, U2.66, U9.26
SPI_MISO: J10.6, U2.125, U5001.V23
SPI_MOSI: J10.7, U2.126, U5001.AD22
SPI_SCK: J10.5, U2.124, U5001.Y23
SPI_SS: J10.8, U2.127, U5001.AD18
STM3V3: C11.1, C12.1, C13.1, C14.1, C15.1, C16.1, C17.1, C18.1, C19.1, C20.1, C21.1, JP1.1, L2.1, TP9.1, U2.17, U2.39, U2.52, U2.62, U2.72, U2.84, U2.95, U2.106, U2.108, U2.121, U2.131, U2.144
SW0: R5007.1, SW5002.10, U5001.R1
SW1: R5008.1, SW5002.9, U5001.U1
SW2: R5009.1, SW5002.8, U5001.AC19
SW3: R5011.1, SW5002.7, U5001.AC17
SW4: R5012.1, SW5002.6, U5001.AC15
SWDCLK: P5001.2, U5001.AA24
SWDIO: P5001.4, U5001.AC24
UART_BC95_RX: J7.7, R68.2, U2.44
UART_BC95_TX: J7.9, R69.2, U2.70
UART_GPS_RX: J16.3, U2.101, U10.22
UART_GPS_TX: J16.1, U2.102, U10.21
UART_M95_RX: J7.3, R73.1, R74.2, U2.36
UART_M95_TX: J7.5, R77.1, U2.37
USIM_CLK: R62.2, U8.41, U9.30
USIM_DATA: R64.2, U8.40, U9.29
USIM_GND: C44.1, J18.C5, J18.G1, J18.G2, J18.G3, J18.G4, J18.G5, J18.G6, U8.42, U9.31
USIM_RST: R65.2, U8.39, U9.28
USIM_VDD: C44.2, D13.1, J18.C1, TP7.1, U8.38, U9.27
nRF_Interrupt: J14.6, U2.26, U5001.K2
