dettmaru/Release/Software/Motherboard_BLE_2s/Src/main.c

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

/* Includes ------------------------------------------------------------------*/
#include "main.h"
#include "adc.h"
#include "crc.h"
#include "dma.h"
#include "fatfs.h"
#include "i2c.h"
#include "iwdg.h"
#include "lptim.h"
#include "usart.h"
#include "rng.h"
#include "rtc.h"
#include "sdmmc.h"
#include "spi.h"
#include "tim.h"
#include "usb_device.h"
#include "gpio.h"

/* USER CODE BEGIN Includes */
#include "usbd_core.h"
#include "Logging.h"
/* USER CODE END Includes */

/* USER CODE BEGIN PM */
#define BLE_SENSOR_BUFFER_ELEMENTS 10
/* USER CODE END PM */


/* USER CODE BEGIN PV */

/* USER CODE END PV */

void SystemClock_Config(void);
static void MX_NVIC_Init(void);
/* USER CODE BEGIN PFP */

/* USER CODE END PFP */

/* USER CODE BEGIN 0 */
void CallMain();
/* USER CODE END 0 */

/**
  * @brief  The application entry point.
  * @retval int
  */
int main(void)
{
  /* MCU Configuration--------------------------------------------------------*/

  /* Reset of all peripherals, Initializes the Flash interface and the Systick. */
  HAL_Init();

  /* USER CODE BEGIN Init */
#ifdef DEBUG
  DBGMCU->CR |= DBGMCU_CR_DBG_SLEEP | DBGMCU_CR_DBG_STOP | DBGMCU_CR_DBG_STANDBY;
  //DBGMCU->CR |= DBGMCU_CR_DBG_SLEEP | DBGMCU_CR_DBG_STOP;
#endif

  /* USER CODE END Init */

  /* Configure the system clock */
  SystemClock_Config();

  /* USER CODE BEGIN SysInit */
  
  hrtc.Instance = RTC;
  if(HAL_RTCEx_BKUPRead(&hrtc, RTC_BKP_DR0) != 0x32F2){
    // Only init RTC when not initialized
    MX_RTC_Init();
    HAL_RTCEx_BKUPWrite(&hrtc,RTC_BKP_DR0,0x32F2);
  }
  /* USER CODE END SysInit */

  /* Initialize all configured peripherals */
  MX_GPIO_Init();
  MX_DMA_Init();
  MX_LPTIM1_Init();
  MX_USART2_UART_Init();
  MX_IWDG_Init();
  MX_LPUART1_UART_Init();

  /* Initialize interrupts */
  MX_NVIC_Init();
  /* USER CODE BEGIN 2 */

  //MX_USB_DEVICE_Init();

  CallMain();
  /* USER CODE END 2 */

  /* Infinite loop */
  /* USER CODE BEGIN WHILE */
  while (1)
  {
    /* USER CODE END WHILE */

    /* USER CODE BEGIN 3 */
  }
  /* USER CODE END 3 */
}

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
/* USER CODE BEGIN 4 */
void _Error_Handler(char* file, int line)
{
	LOGE("Tag",  "_Error_Handler called in %s on line %d", file, line);
	Error_Handler();
}
/* USER CODE END 4 */
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
