dettmaru/Release/(notices)

Notices in the files:
Software/Motherboard_BLE_2s/Src/main.c:
© Copyright (c) 2019 STMicroelectronics.
All rights reserved.
